xuanvuong1702/flytex-camera/hardware/audit/README.md

# Log kiểm tra ba vòng 8–10

Ba vòng chạy lại toàn bộ trên commit `8a23349`, không dựa vào kết quả vòng trước.

| Vòng | `run_tests.py` | Test | `readiness.py --full` | Blocker |
|---|---|---|---|---|
| 8 | 47/47 bước | 512 | 26/26 đạt | 0 cứng, 4 cảnh báo |
| 9 | 47/47 bước | 512 | 26/26 đạt | 0 cứng, 4 cảnh báo |
| 10 | 47/47 bước | 512 | 26/26 đạt | 0 cứng, 4 cảnh báo |

- CI GitHub Actions: `success`, run `42642975243`, commit `8a23349`.
- Đây là bằng chứng nội bộ + CI; các phép đo phần cứng thật vẫn thuộc G0 (M-02, M-05, M-36, ILIM, port target, TLS MQTT).

Kết luận: đủ điều kiện **bắt đầu dựng prototype** (schematic/layout) với 1 giả định PACK; không đủ điều kiện sản xuất/giao vận.
