xuanvuong1702/flytex-camera/hardware/kicad/pinout-power.md

# Bảng chân IC nguồn (sinh tự động)

## BQ25070

- Datasheet: https://www.ti.com/lit/ds/symlink/bq25070.pdf
- Footprint: `Package_SON:TI_DQC0010A`

| Pin | Tên | Kiểu |
|---|---|---|
| 1 | IN | power_in |
| 2 | IMON | output |
| 3 | GND | power_in |
| 4 | LDO | power_out |
| 5 | TS | input |
| 6 | BAT | passive |
| 7 | CTRL | input |
| 8 | CHG | open_collector |
| 9 | GND | power_in |
| 10 | OUT | power_out |
| 11 | PAD | power_in |

## TPS61088

- Datasheet: https://www.ti.com/lit/ds/symlink/tps61088.pdf
- Footprint: `Package_DFN_QFN:Texas_VQFN-RHL-20`

| Pin | Tên | Kiểu |
|---|---|---|
| 1 | VCC | power_out |
| 2 | EN | input |
| 3 | FSW | input |
| 4 | SW | passive |
| 5 | SW | passive |
| 6 | SW | passive |
| 7 | SW | passive |
| 8 | BOOT | passive |
| 9 | VIN | power_in |
| 10 | SS | passive |
| 11 | NC | no_connect |
| 12 | NC | no_connect |
| 13 | MODE | input |
| 14 | VOUT | power_out |
| 15 | VOUT | passive |
| 16 | VOUT | passive |
| 17 | FB | input |
| 18 | COMP | passive |
| 19 | ILIM | passive |
| 20 | AGND | power_in |
| 21 | PGND | power_in |

## TPS62840

- Datasheet: https://www.ti.com/lit/ds/symlink/tps62840.pdf
- Footprint: `Package_SON:VSON-8_1.5x2mm_P0.5mm`

| Pin | Tên | Kiểu |
|---|---|---|
| 1 | GND | power_in |
| 2 | VIN | power_in |
| 3 | MODE | input |
| 4 | EN | input |
| 5 | VSET | input |
| 6 | STOP | input |
| 7 | SW | passive |
| 8 | VOS | input |
| 9 | PAD | power_in |

## TPS22918

- Datasheet: https://www.ti.com/lit/ds/symlink/tps22918.pdf
- Footprint: `Package_TO_SOT_SMD:SOT-23-6`

| Pin | Tên | Kiểu |
|---|---|---|
| 1 | VIN | power_in |
| 2 | GND | power_in |
| 3 | ON | input |
| 4 | CT | passive |
| 5 | QOD | passive |
| 6 | VOUT | power_out |
