xuanvuong1702/flytex-camera/docs/18-tai-lieu-linh-kien.md

# 18 — Tài liệu linh kiện và đối chiếu thiết kế

- Trạng thái: rà soát v1.0, ngày 2026-11-09
- Nguồn máy đọc: [spec/parts.toml](../spec/parts.toml) → sinh [hardware/parts-register.md](../hardware/parts-register.md)
- Công cụ: `python -m hardware.parts.check --strict` (cổng trước khi mua)

## 1. Cách làm

1. Mỗi linh kiện trong BOM có một mục trong `spec/parts.toml`: MPN, nhà sản xuất, URL datasheet, gói, các thông số then chốt, mức xác minh.
2. Mức xác minh: `yes` = đã mở datasheet và đối chiếu; `partial` = mới một phần; `no` = chưa mở, không được dùng để chốt mua.
3. Bộ kiểm tra đối chiếu từng thông số với yêu cầu thiết kế (dải áp, dòng, nhiệt, gói, chức năng) và bắt buộc mọi MPN quan trọng trong BOM phải có trong sổ.
4. Còn `blocker` thì **không đặt hàng**; `warn` thì ghi nhận và đo/kiểm ở G0.

## 2. Kết quả hiện tại

**15 linh kiện + 4 module ngoài BOM; 0 blocker cứng, 1 giả định PACK, 4 cảnh báo** (sau khi chọn BQ25070 và nhập pinout).

### 2.1 Giả định phải đo trước G0

| Mục | Vấn đề | Cách đóng | Nơi ghi |
|---|---|---|---|
| U3 sạc | **BQ25070**: float 3,5 V, power-path (1,2 A), NTC, standalone; **935 mA bằng 11 xung CTRL**; R1/R2 = 20 kΩ/8,25 kΩ | Còn đo M-05, kiểm tồn kho và đo đỉnh tải | O-05 |
| SOC | Đã nạp **112 chân** Core1106D vào `spec/core1106d/pins.csv` | Đối chiếu với bản vẽ cơ khí và bảng ánh xạ CMP trước khi vẽ | O-11 |
| PACK | Giả định BMS tự tiêu **50 µA**; UN38.3/IEC đang chờ | Chỉ prototype trên bàn; đo M-02; `--production` sẽ fail tới khi có hồ sơ | O-03 |

### 2.2 Cảnh báo (không chặn đặt, phải đo ở G0)

| Mục | Vấn đề | Xử lý |
|---|---|---|
| MODEM | Đỉnh dòng 2 A là giả định | Đo M-36 bằng shunt + oscilloscope; nếu lớn hơn, tách rail modem hoặc boost lớn hơn |
| J1 USB-C | Receptacle hiện chưa phải loại chống nước | Chốt O-06 (receptacle IP67 hoặc khoang kín có nắp) trước khi làm vỏ |
| L1 cuộn cảm | Isat 9 A chưa xác minh ở 125 °C | Đọc datasheet Vishay, kiểm đường cong Isat theo nhiệt độ |

## 3. Những gì đã đối chiếu và đúng

| Linh kiện | Đã xác nhận | Ghi chú |
|---|---|---|
| TPS61088 | Gói VQFN-20; Vin 2,7–12 V; Vref 1,204 V; Vout tới 12,6 V | Phù hợp boost 5 V/3 A; ILIM/fsw vẫn cần đối chiếu công thức datasheet |
| TPS62840 | Vin 1,8–6,5 V; Iout 0,75 A; Iq 60 nA; **DLC = SON-8 1,5×2**; VSET=267 kΩ cho 3,3 V | Bản CAM4G đúng; đã đọc Table 1 datasheet |
| STM32L031G6U6 | **UFQFPN-28**; STOP 0,4 µA; 24 GPIO; −40…85 °C | Đủ chân; thiết kế không phụ thuộc I2C wakeup vì MCU thức khi SoC bật |
| M24C32-FMN6TP | **SO-8 150 mil**; 1,7–5,5 V; I2C | Bản CAM4G đúng; lần sửa sang TSSOP-8 là sai, đã khôi phục |
| TPS22918 | 5,5 V; 2 A; Rds(on) ~55 mΩ | Đủ cho +5V_MODEM 1,8 A và +5V_SOC 1,5 A |
| TS3USB221A | USB 2.0 HS; 2 kênh | Dùng cho mux modem/pad nạp (nếu chốt D-20) |
| Core1106D1408 | 1 cổng USB; eMMC 8 GB; 112 chân | Khớp D-19/D-20; thiếu bản vẽ chân |
| EC200U-EU | VBAT 3,3–4,3 V; USB HS; **MAIN_RI chân 62** | Đã có hardware design; còn đo đỉnh dòng/eDRX |

## 4. Tối ưu và điều chỉnh đề xuất

1. **Buck:** nếu TPS62840 chỉ có bản chỉnh được, thêm cặp điện trở hồi tiếp E96 và ghi giá trị vào [pwr-design](../hardware/pwr-design.md) bằng cách mở rộng `hardware/calc/design.py`. Nếu có bản cố định 3,3 V, chọn bản đó để bớt 2 linh kiện và một nguồn sai số.
2. **Sạc:** BQ25798 **không dùng được** cho kiến trúc này (mặc định 4,2 V, watchdog, không có I2C master khi SoC tắt). Chọn IC float LFP bằng phần cứng; nếu là sạc tuyến tính 1 A thì chấp nhận chậm hơn để đổi lấy an toàn.
3. **MCU:** không cần I2C wakeup từ STOP nếu MCU chỉ ngủ khi SoC tắt; khi SoC bật, MCU thức và trả lời I2C. Ghi rõ trong port STM32L0 để người viết không đi tìm tính năng không cần.
4. **B2B:** dòng mỗi chân 1 A của Samtec TSM cần xác nhận trong datasheet; nếu thấp hơn, tăng số chân nguồn hoặc đổi connector.
5. **USB-C:** chốt phương án chống nước trước khi vẽ vỏ, vì nó quyết định khoét vỏ và chiều cao connector.
6. **Đo trước khi tối ưu:** đỉnh modem và dòng ngủ là hai số quyết định kích thước boost/pin; đừng đổi linh kiện trước M-36/M-02.

## 5. Bộ tài liệu cần thu thập (đang thiếu)

| Tài liệu | Cho | Trạng thái |
|---|---|---|
| `Core1106D-PinOut.xls`, `Core1106D.pdf` (Luckfox) | Vẽ CMP, gán chân 112 | **Chưa nạp** |
| EC200U Hardware Design (Quectel) | VBAT, đỉnh dòng, RI, USB | Đã dẫn, chưa trích số |
| Datasheet IC sạc mới (LTC4162-L / LTC4098-3.6 / CN3058E) | Chốt float, NTC, power-path | **Chưa có** |
| TPS62840 datasheet bản gói DLC | Vref, divider, footprint | Chưa đối chiếu |
| TPS61088 datasheet (ILIM, fsw, COMP) | Chốt giá trị bù | Chưa đối chiếu đầy đủ |
| STM32L031 datasheet + reference manual | STOP, I2C, ADC, chân | Một phần |
| SC3336 3MP Camera (B) pinout 20 chân | CMP, firmware camera | **Đã có** trong `spec/camera/` |
| Pack/BMS datasheet, UN38.3, IEC 62133, tự tiêu | Mua pack, an toàn | **Chưa có** |
| Antenna datasheet (VSWR, gain, keepout) | Vỏ, RF | **Chưa có** |
| USB-C receptacle IP67 datasheet | Vỏ | **Chưa có** |
| Bản vẽ cơ khí connector (Samtec, Hirose, Amass) | Footprint, 3D | Một phần |

Danh sách việc và thứ tự ưu tiên trước khi mua: [19-truoc-khi-mua.md](19-truoc-khi-mua.md).

## 6. Cách cập nhật

1. Mở datasheet, xác nhận một thông số.
2. Sửa `spec/parts.toml`: `verified`, `source`, giá trị.
3. `python -m hardware.parts.check --write` để sinh lại bảng.
4. `python -m hardware.parts.check --strict` phải hết blocker mới đặt hàng.
5. Ghi ngày và người xác nhận vào cột `source` hoặc `notes`.

## 7. Đính chính sau rà soát độc lập 2026-11-09

Rà soát bên ngoài (Ubuntu + gcc 13.3 + datasheet) phát hiện các lỗi mà bộ kiểm tra nội bộ không bắt được:

1. **CI đỏ** vì `regmap.c` thiếu `<stddef.h>`; đã sửa 4 file nguồn + 3 header + 9 file test và thêm lint. Run `42613060903` (commit `08a35e7`) đã **success**.
2. **BQ25798 không an toàn** cho LFP 1S; đã loại và thay bằng **BQ25070** (D-23).
3. **Hai đính chính gói ở vòng 1 là sai**: TPS62840 là SON-8 1,5×2, M24C32 là SO-8; đã khôi phục.
4. **NTC 7,15 kΩ** thuộc IC cũ; mục 4 của pwr-design đã tạm hoãn.
5. **+3V3 là 3,0–3,3 V**, không phải 3,3 V cố định.
6. **BOM thiếu linh kiện phụ**; đã thêm các dòng boost/USB/load-switch và đánh dấu phần phụ thuộc IC sạc là `not-chosen`.
7. **Ngưỡng pin LFP** đã sửa (3,05/2,90/3,20 V + lọc/đếm mẫu). **SMS** đã có HMAC/timestamp/chống replay; còn thiếu giới hạn tần suất ở MCU và whitelist số — ghi ở [17](17-san-sang-prototype.md) vòng 7.
8. **Công tắc tải modem TPS22918 (2 A) dùng cho rail 1,8 A** chỉ dư ~11 %; tụ 470 µF sau công tắc có thể tạo dòng nạp vượt 2 A. Đã thêm tụ CT (C9) nhưng phải đo dòng khởi động ở M-36; nếu vượt, đổi công tắc tải lớn hơn hoặc giảm tụ/soft-start.
9. **Tụ ra boost 2×22 µF 1206 10 V X7R** mất nhiều dung lượng do DC bias ở 5 V. Phải tra đường cong C(V) trong datasheet tụ, có thể phải tăng số tụ hoặc dùng 16 V; kiểm gợn và ổn định ở M-08.

Bài học: test BOM chỉ kiểm **nhất quán nội bộ**, không chứng minh gói hay thông số đúng datasheet. Mọi `verified=yes` phải kèm nguồn và người kiểm.
