xuanvuong1702/flytex-camera/spec/generated/pinout_pwr_cmp.csv

pin | signal | net | direction | max_a
1 | +5V_SOC | +5V_SOC | PWR->CMP | 1.0
2 | +5V_MODEM | +5V_MODEM | PWR->CMP | 1.0
3 | +5V_SOC | +5V_SOC | PWR->CMP | 1.0
4 | +5V_MODEM | +5V_MODEM | PWR->CMP | 1.0
5 | +5V_SOC | +5V_SOC | PWR->CMP | 1.0
6 | GND | GND | - | 1.0
7 | GND | GND | - | 1.0
8 | GND | GND | - | 1.0
9 | +3V3 | +3V3 | PWR->CMP | 0.75
10 | GND | GND | - | 1.0
11 | +3V3 | +3V3 | PWR->CMP | 0.75
12 | GND | GND | - | 1.0
13 | I2C_SDA | I2C_SDA | bidir
14 | I2C_SCL | I2C_SCL | bidir
15 | MCU_IRQ | MCU_IRQ | PWR->CMP
16 | SOC_READY | SOC_READY | CMP->PWR
17 | MODEM_PWRKEY | MODEM_PWRKEY | PWR->CMP
18 | MODEM_RESET | MODEM_RESET | PWR->CMP
19 | MODEM_STATUS | MODEM_STATUS | CMP->PWR
20 | USB_SEL | USB_SEL | PWR->CMP
21 | MODEM_RI | MODEM_RI | CMP->PWR
22 | SPARE_SOC2 | SPARE_SOC2 | CMP->PWR
23 | +5V_MODEM | +5V_MODEM | PWR->CMP | 1.0
24 | GND | GND | - | 1.0
25 | GND | GND | - | 1.0
26 | GND | GND | - | 1.0
