xuanvuong1702/flytex-camera/hardware/kicad/flytex-cmp-full.png

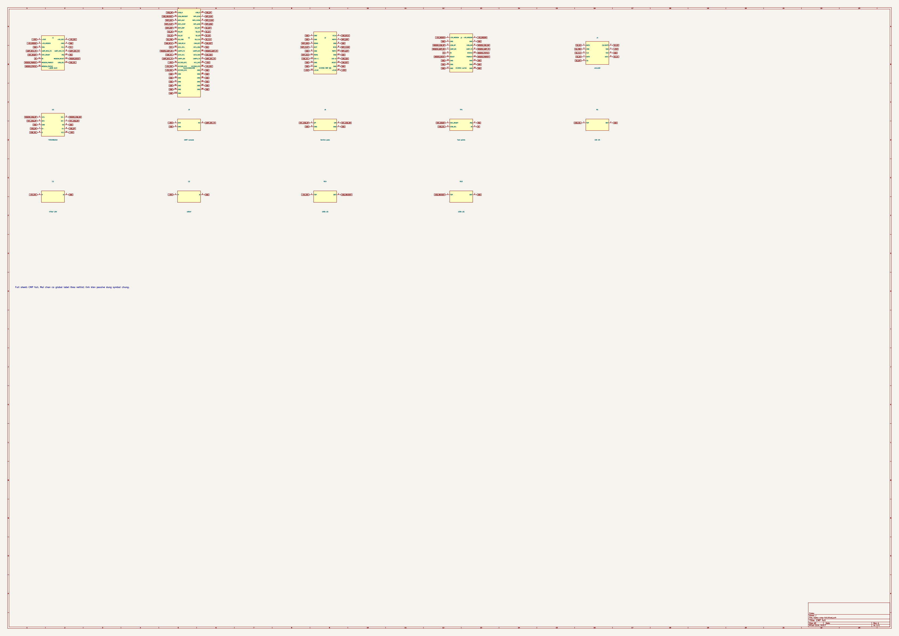
hardware/kicad/flytex-cmp-full.png
