xuanvuong1702/flytex-camera/hardware/kicad/flytex-pwr-full.png

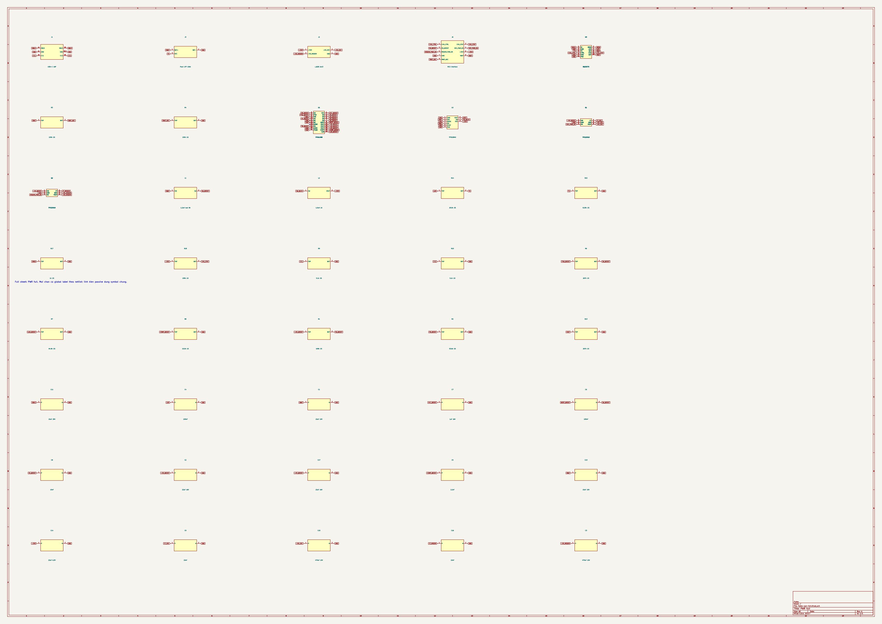
hardware/kicad/flytex-pwr-full.png
