xuanvuong1702/flytex-camera/hardware/kicad/flytex-pwr.png

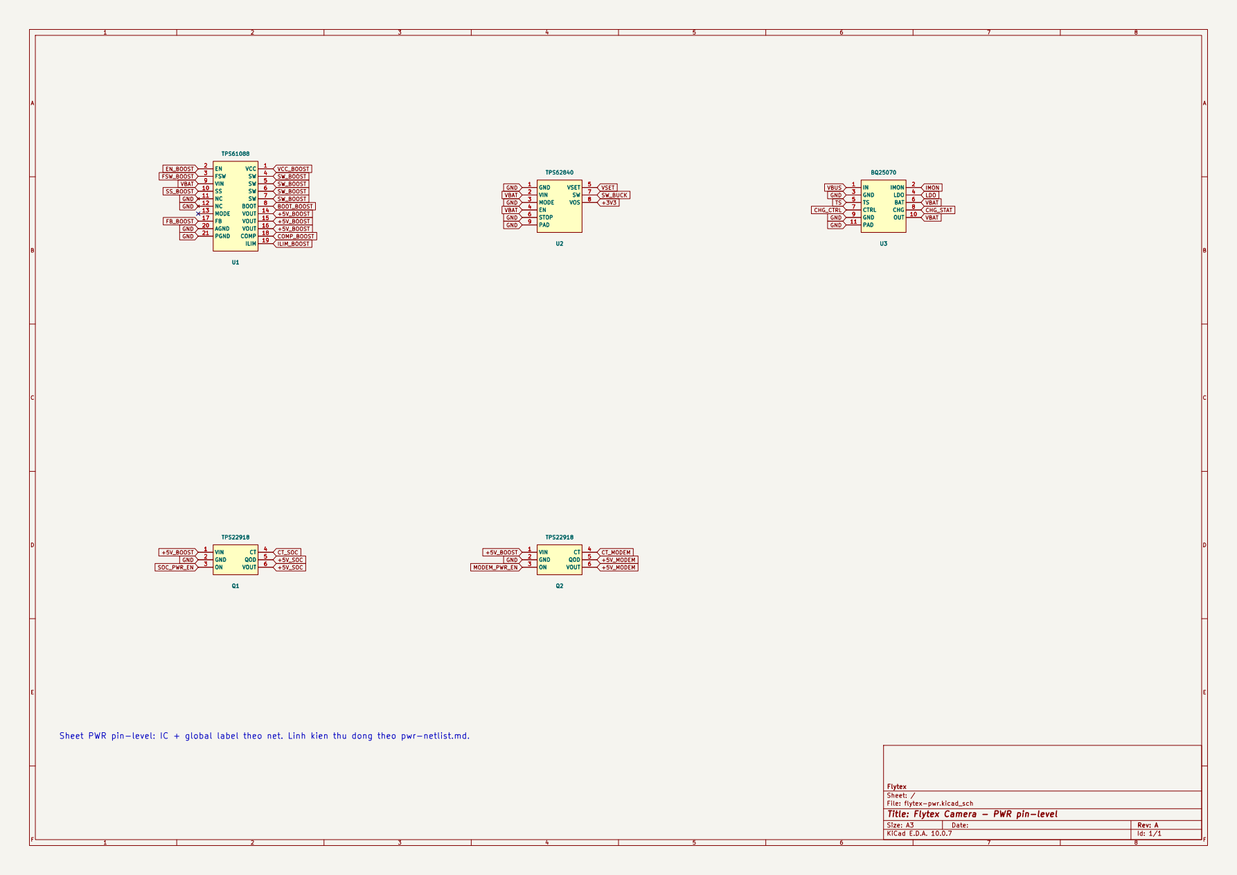
hardware/kicad/flytex-pwr.png
