xuanvuong1702/flytex-camera/devkit/bom.csv

item | qty | example | role | approx_usd | note
SBC | 1 | Luckfox Pico Ultra (RV1106 | 256MB | WiFi) | Chạy Linux + camera + app | 45 | Cần board có FPC camera và USB host; nếu có Core1106D dev board thì dùng board đó
Camera | 1 | Luckfox SC3336 3MP module B | Camera MIPI 2 lane | 25 | Đúng module B; kiểm FPC 20 pin 0.5 mm
Modem | 1 | Quectel EC200U-EU EVB (USB) | 4G Cat.1 + USB + SIM | 55 | EVB có USB; kiểm ăng-ten và SIM
Antenna | 1 | LTE antenna SMA + u.FL adapter | Thu phát LTE | 8 | Đúng băng tần 700/800/900/1800/2100 MHz
SIM | 1 | SIM data LTE (Viettel/Vina/Mobi) | Kết nối mạng | 5 | Có APN; gói data tối thiểu
PSU | 1 | 5V 3A DC adapter + đầu DC/dupont | Cấp nguồn qua header 5V/GND | 12 | Không cấp qua USB-C nếu cắm modem USB-A; kiểm silkscreen 5V
USB-TTL | 1 | CH340/CP2102 3.3V | UART console/debug | 5 | Mức 3.3V, không dùng 5V TTL
Hub | 1 | USB 2.0 hub có nguồn 5V/2A | Cắm modem qua USB-A | 12 | Modem đỉnh >1,5 A; hub phải đủ dòng
microSD | 1 | 16GB Class10 | Image/boot | 8 | Kiểm board boot từ SD hay eMMC
Power meter | 1 | USB-C/DC power meter hoặc shunt | Đo dòng/áp | 15 | Đo nhánh Pico và nhánh modem
Wires | 1 | Bộ dây dupont + SMA pigtail | Đấu nối | 6 | Giữ ngắn, tránh vòng dây nguồn
Enclosure | 1 | Hộp nhựa 100x70x30 mm | Đựng board | 5 | Tùy chọn cho test
Battery | 0 | - | Chỉ khi test nguồn pin | - | Devkit chạy nguồn bench trước; pack để sau
PoE | 1 | Luckfox PoE module (tuỳ chọn) | Cấp nguồn qua Ethernet để giữ USB-A | 15 | Cần switch/PoE injector 802.3af
