xuanvuong1702/flytex-camera/hardware/bom/pwr-rev-a.csv

ref | block | value | mpn | manufacturer | package | qty | dnp | verify | notes
U1 | boost | 5V 3A boost | TPS61088RHLR | Texas Instruments | VQFN-20 | 1 | no | candidate | Vref va fsw va ilim phai doi chieu datasheet
U2 | buck | 3V3 0.75A buck | TPS62840DLCR | Texas Instruments | SON-8 1.5x2mm | 1 | no | candidate | Goi DLC = SON-8 1.5x2 (CAM4G dung); dat VOUT bang dien tro VSET (khong phai divider 2R)
U3 | charger | 1S LFP linear charger 1A | BQ25070DQCR | Texas Instruments | WSON-10 3x2mm | 1 | no | candidate | Float 3.5 V co dinh + power path + NTC + standalone; 1 A tuyen tinh ~1.5 W; phai doc datasheet de tinh CTRL/NTC
U4 | mcu | STM32L031G6U6 | STM32L031G6U6 | STMicroelectronics | UFQFPN-28 | 1 | no | candidate | Goi G6 = UFQFPN-28; kiem chan I2C wakeup va STOP
U5 | nvm | 32Kbit I2C EEPROM | M24C32-FMN6TP | STMicroelectronics | SO-8 150mil | 1 | no | candidate | Luu mode/lich/boot count; MN = SO8
Q1 | soc_switch | load switch TPS22918 | TPS22918DBVR | Texas Instruments | SOT-23-6 | 1 | no | candidate | Rail +5V_SOC
Q2 | modem_switch | load switch TPS22918 | TPS22918DBVR | Texas Instruments | SOT-23-6 | 1 | no | candidate | Rail +5V_MODEM >=1.8 A
L1 | boost | 1.2uH Isat 9A | IHLP2525CZER1R2M01 | Vishay | 2525 | 1 | no | candidate | Kiem Isat o 125 do C
D1 | usb_esd | ESD array USBLC6-2SC6 | USBLC6-2SC6 | STMicroelectronics | SOT-23-6 | 1 | no | candidate | USB-C VBUS va D-/D+ khong dung
F1 | usb_ptc | PTC 0.75A 30V | MF-MSMF075 | BOURNS | 1812 | 1 | no | candidate | Bao ve cong USB-C
J1 | usb_c | USB-C receptacle 16P | USB4085-GF-A | GCT | USB-C | 1 | no | candidate | Phien ban chong nuoc la O-06
J2 | b2b | header 2x13 2.54 keyed | TSM-113-01-L-DV | Samtec | 2x13 | 1 | no | candidate | Phai khop spec/b2b.toml 26 chan
J3 | pack | BAT+ BAT- >=10A | XT30PW-M | Amass | 2 pin | 1 | no | candidate | Co khoa chong nguoc
J4 | swd | header 1x6 2.54 | TSW-106-07-G-S | Samtec | 1x6 | 1 | no | candidate | SWDIO SWCLK NRST GND 3V3
J5 | sensors | header 1x6 2.54 | TSW-106-07-G-S | Samtec | 1x6 | 1 | no | candidate | 3V3 PIR GND 3V3 DQ GND
R1 | boost_fb | 169k 1% | RC0603FR-07169KL | Yageo | 0603 | 1 | no | candidate | Cap hoi tiep tren
R2 | boost_fb | 53.6k 1% | RC0603FR-0753K6L | Yageo | 0603 | 1 | no | candidate | Cap hoi tiep duoi
R3 | batt_div | 100k 1% | RC0603FR-07100KL | Yageo | 0603 | 1 | no | candidate | Chia ap pin
R4 | batt_div | 100k 1% | RC0603FR-07100KL | Yageo | 0603 | 1 | no | candidate | Chia ap pin
C1 | boost_in | 10uF 25V X7R | CL31B106KBHNNNE | Samsung | 1206 | 2 | no | candidate | Sat IC boost
C2 | boost_out | 22uF 10V X7R | CL31B226KPHNNNE | Samsung | 1206 | 2 | no | candidate
C3 | modem_bulk | 470uF 10V low ESR | EEU-FR1A471 | Panasonic | radial 8x11 | 1 | no | candidate | Dat SAU cong tac tai va sat modem; kiem dong nap voi CT C9
C4 | decouple | 100nF 50V X7R | CL10B104KB8NNNC | Samsung | 0603 | 12 | no | candidate | Theo tung IC
R5 | ntc_pull | 7.15k 1% | RC0603FR-077K15L | Yageo | 0603 | 1 | yes | dnp | KHONG DUNG: gia tri cua IC CAM4G cu
TP1 | testpoint | test point 1.0mm | TP-107-01-T | Samtec | 1 pin | 12 | no | candidate | Moi rail mot diem
R6 | boost_fsw | 267k 1% | RC0603FR-07267KL | Yageo | 0603 | 1 | no | candidate | Rfsw theo datasheet TPS61088
R7 | boost_ilim | 64.9k 1% | RC0603FR-0764K9L | Yageo | 0603 | 1 | no | candidate | Rilim theo datasheet
R8 | boost_comp | 10.5k 1% | RC0603FR-0710K5L | Yageo | 0603 | 1 | no | candidate | Mang COMP - chua do Bode
C5 | boost_comp | 2.2nF 50V X7R | CL10B222KB8NNNC | Samsung | 0603 | 1 | no | candidate | Mang COMP
C6 | boost_boot | 100nF 50V X7R | CL10B104KB8NNNC | Samsung | 0603 | 1 | no | candidate | Tu boot
C7 | boost_vcc | 1uF 16V X7R | CL10B105KO8NNNC | Samsung | 0603 | 1 | no | candidate | Tu VCC
C8 | boost_ss | 10nF 50V X7R | CL10B103KB8NNNC | Samsung | 0603 | 1 | no | candidate | Tu soft-start
R9 | usb_cc | 5.1k 1% | RC0603FR-075K1L | Yageo | 0603 | 1 | no | candidate | Rd cho CC1
R10 | usb_cc | 5.1k 1% | RC0603FR-075K1L | Yageo | 0603 | 1 | no | candidate | Rd cho CC2
D2 | usb_vbus_tvs | TVS 5V standoff | SMBJ5.0A | Bourns | SMB | 1 | no | candidate | Bao ve VBUS; USBLC6 chi bao ve data
C9 | load_switch_ct | 10nF 50V X7R | CL10B103KB8NNNC | Samsung | 0603 | 2 | no | candidate | Chinh slew dong nap 470uF
L2 | buck_inductor | 1.0uH 1.2A | LQH3NPN1R0MM0L | Murata | 1210 | 1 | no | candidate | Cuon cam buck 3V3; kiem Isat/DCR
C10 | charger_pmid | chua chon |  |  | chua chon | 1 | yes | dnp | Khong dung cho sac tuyen tinh
C11 | charger_vbus | 10uF 16V X7R | CL31B106KO8NNNE | Samsung | 1206 | 1 | no | candidate | Tu vao VBUS theo datasheet BQ25070
C12 | charger_sys | 10uF 10V X7R | CL31B106KPHNNNE | Samsung | 1206 | 2 | no | candidate | Tu SYS/BAT theo datasheet BQ25070
R11 | charger_ctrl | KHONG DUNG (CTRL xung) |  |  | chua chon | 1 | yes | dnp | BQ25070 CTRL la giao dien xung 1 day - khong co dien tro; can GPIO MCU
R14 | charger_ts_top | 20.0k 1% | RC0603FR-0720KL | Yageo | 0603 | 1 | no | candidate | R1 LDO->TS theo datasheet BQ25070; cat nong 44.9 C
R15 | charger_ts_bottom | 8.25k 1% | RC0603FR-078K25L | Yageo | 0603 | 1 | no | candidate | R2 TS->GND; cat lanh -0.6 C
R13 | buck_vset | 267k 1% | RC0603FR-07267KL | Yageo | 0603 | 1 | no | candidate | VSET=267k theo Table 1 datasheet TPS62840 (trang 13) cho VOUT 3.3 V
R16 | buck_mode | 0R 1% | RC0603FR-070RL | Yageo | 0603 | 1 | no | candidate | Keo MODE xuong GND: PFM cho dong nghi thap
R17 | charger_imon | 1k 1% | RC0603FR-071KL | Yageo | 0603 | 1 | no | candidate | IMON: 1 V tuong ung 1 A
R18 | charger_chg | 100k 1% | RC0603FR-07100KL | Yageo | 0603 | 1 | no | candidate | Pull-up CHG (open-drain) len +3V3
C13 | buck_in | 10uF 10V X7R | CL31B106KPHNNNE | Samsung | 1206 | 1 | no | candidate | Tu vao buck 3V3
C14 | buck_out | 22uF 6.3V X7R | CL31B226KPHNNNE | Samsung | 1206 | 1 | no | candidate | Tu ra buck 3V3
C15 | soc_bulk | 470uF 10V low ESR | EEU-FR1A471 | Panasonic | radial 8x11 | 1 | no | candidate | Bulk rail +5V_SOC
C16 | load_switch_ct | 10nF 50V X7R | CL10B103KB8NNNC | Samsung | 0603 | 1 | no | candidate | CT cho cong tac modem
C17 | boost_out | 22uF 16V X7R | CL31B226KOHNNNE | Samsung | 1206 | 1 | no | candidate | Tu ra boost thu hai
J6 | mcu_if | header 1x9 2.54 | TSW-109-07-G-S | Samtec | 1x9 | 1 | no | candidate | CHG_CTRL CHG_STAT EN_BOOST SOC/MODEM_PWR_EN 3V3 GND VBAT VBAT_ADC
