xuanvuong1702/flytex-camera/hardware/netlist/cmp-netlist.csv

ref | value | footprint | pin | pin_name | net
J1 | J_B2B 2x13 | Connector_PinSocket_2.54mm:PinSocket_2x13_P2.54mm_Vertical | 1 | +3V3 | +3V3
J1 | J_B2B 2x13 | Connector_PinSocket_2.54mm:PinSocket_2x13_P2.54mm_Vertical | 2 | +5V_SOC | +5V_SOC
J1 | J_B2B 2x13 | Connector_PinSocket_2.54mm:PinSocket_2x13_P2.54mm_Vertical | 3 | +5V_MODEM | +5V_MODEM
J1 | J_B2B 2x13 | Connector_PinSocket_2.54mm:PinSocket_2x13_P2.54mm_Vertical | 4 | GND | GND
J1 | J_B2B 2x13 | Connector_PinSocket_2.54mm:PinSocket_2x13_P2.54mm_Vertical | 5 | SDA | SDA
J1 | J_B2B 2x13 | Connector_PinSocket_2.54mm:PinSocket_2x13_P2.54mm_Vertical | 6 | SCL | SCL
J1 | J_B2B 2x13 | Connector_PinSocket_2.54mm:PinSocket_2x13_P2.54mm_Vertical | 7 | UART_MCU_TX | UART_MCU_TX
J1 | J_B2B 2x13 | Connector_PinSocket_2.54mm:PinSocket_2x13_P2.54mm_Vertical | 8 | UART_SOC_TX | UART_SOC_TX
J1 | J_B2B 2x13 | Connector_PinSocket_2.54mm:PinSocket_2x13_P2.54mm_Vertical | 9 | SOC_READY | SOC_READY
J1 | J_B2B 2x13 | Connector_PinSocket_2.54mm:PinSocket_2x13_P2.54mm_Vertical | 10 | IRQ | IRQ
J1 | J_B2B 2x13 | Connector_PinSocket_2.54mm:PinSocket_2x13_P2.54mm_Vertical | 11 | RI | RI
J1 | J_B2B 2x13 | Connector_PinSocket_2.54mm:PinSocket_2x13_P2.54mm_Vertical | 12 | MODEM_RESET | MODEM_RESET
J1 | J_B2B 2x13 | Connector_PinSocket_2.54mm:PinSocket_2x13_P2.54mm_Vertical | 13 | MODEM_PWRKEY | MODEM_PWRKEY
J1 | J_B2B 2x13 | Connector_PinSocket_2.54mm:PinSocket_2x13_P2.54mm_Vertical | 14 | USB_SEL | USB_SEL
J1 | J_B2B 2x13 | Connector_PinSocket_2.54mm:PinSocket_2x13_P2.54mm_Vertical | 15 | MODEM_STATUS | MODEM_STATUS
U1 | Core1106D1408 | flytex:Core1106D | 22 | USB_N | USB_DM
U1 | Core1106D1408 | flytex:Core1106D | 23 | USB_P | USB_DP
U1 | Core1106D1408 | flytex:Core1106D | 24 | USB_VBUSDET | USB_VBUSDET
U1 | Core1106D1408 | flytex:Core1106D | 7 | MIPI_D1N | MIPI_D1N
U1 | Core1106D1408 | flytex:Core1106D | 8 | MIPI_D1P | MIPI_D1P
U1 | Core1106D1408 | flytex:Core1106D | 9 | MIPI_CK0N | MIPI_CLKN
U1 | Core1106D1408 | flytex:Core1106D | 10 | MIPI_CK0P | MIPI_CLKP
U1 | Core1106D1408 | flytex:Core1106D | 11 | MIPI_D0N | MIPI_D0N
U1 | Core1106D1408 | flytex:Core1106D | 12 | MIPI_D0P | MIPI_D0P
U1 | Core1106D1408 | flytex:Core1106D | 48 | SD_DET | SD_DET
U1 | Core1106D1408 | flytex:Core1106D | 49 | SD_D0 | SD_D0
U1 | Core1106D1408 | flytex:Core1106D | 50 | SD_D1 | SD_D1
U1 | Core1106D1408 | flytex:Core1106D | 51 | SD_D2 | SD_D2
U1 | Core1106D1408 | flytex:Core1106D | 52 | SD_D3 | SD_D3
U1 | Core1106D1408 | flytex:Core1106D | 53 | SD_CMD | SD_CMD
U1 | Core1106D1408 | flytex:Core1106D | 54 | SD_CLK | SD_CLK
U1 | Core1106D1408 | flytex:Core1106D | 58 | CAM_MCLK | CAM_MCLK
U1 | Core1106D1408 | flytex:Core1106D | 60 | CAM_RST | CAM_RST
U1 | Core1106D1408 | flytex:Core1106D | 63 | I2C1_SCL | SCL
U1 | Core1106D1408 | flytex:Core1106D | 64 | I2C1_SDA | SDA
U1 | Core1106D1408 | flytex:Core1106D | 65 | UART3_TX | MODEM_UART_RX
U1 | Core1106D1408 | flytex:Core1106D | 66 | UART3_RX | MODEM_UART_TX
U1 | Core1106D1408 | flytex:Core1106D | 68 | I2C0_SCL | CAM_SCL
U1 | Core1106D1408 | flytex:Core1106D | 69 | I2C0_SDA | CAM_SDA
U1 | Core1106D1408 | flytex:Core1106D | 70 | UART4_RX | UART_MCU_TX
U1 | Core1106D1408 | flytex:Core1106D | 71 | UART4_TX | UART_SOC_TX
U1 | Core1106D1408 | flytex:Core1106D | 76 | VCC3V3_RTC | +3V3
U1 | Core1106D1408 | flytex:Core1106D | 78 | VCC_3V3 | +3V3
U1 | Core1106D1408 | flytex:Core1106D | 79 | VCC5V0_SYS | +5V_SOC
U1 | Core1106D1408 | flytex:Core1106D | 80 | VCC5V0_SYS | +5V_SOC
U1 | Core1106D1408 | flytex:Core1106D | 81 | VCC5V0_SYS | +5V_SOC
U1 | Core1106D1408 | flytex:Core1106D | 21 | GND | GND
U1 | Core1106D1408 | flytex:Core1106D | 25 | GND | GND
U1 | Core1106D1408 | flytex:Core1106D | 28 | GND | GND
U1 | Core1106D1408 | flytex:Core1106D | 29 | GND | GND
U1 | Core1106D1408 | flytex:Core1106D | 36 | GND | GND
U1 | Core1106D1408 | flytex:Core1106D | 47 | GND | GND
U1 | Core1106D1408 | flytex:Core1106D | 55 | GND | GND
U1 | Core1106D1408 | flytex:Core1106D | 82 | GND | GND
U1 | Core1106D1408 | flytex:Core1106D | 83 | GND | GND
U1 | Core1106D1408 | flytex:Core1106D | 84 | GND | GND
U1 | Core1106D1408 | flytex:Core1106D | 89 | GND | GND
U1 | Core1106D1408 | flytex:Core1106D | 112 | GND | GND
J2 | SC3336 3MP (B) | Connector_FFC-FPC:Hirose_FH12-20S-0.5SH_1x20-1MP_P0.50mm_Horizontal | 1 | GND | GND
J2 | SC3336 3MP (B) | Connector_FFC-FPC:Hirose_FH12-20S-0.5SH_1x20-1MP_P0.50mm_Horizontal | 2 | XCLK | CAM_MCLK
J2 | SC3336 3MP (B) | Connector_FFC-FPC:Hirose_FH12-20S-0.5SH_1x20-1MP_P0.50mm_Horizontal | 3 | GND | GND
J2 | SC3336 3MP (B) | Connector_FFC-FPC:Hirose_FH12-20S-0.5SH_1x20-1MP_P0.50mm_Horizontal | 4 | MDP0 | MIPI_D0P
J2 | SC3336 3MP (B) | Connector_FFC-FPC:Hirose_FH12-20S-0.5SH_1x20-1MP_P0.50mm_Horizontal | 5 | MDN0 | MIPI_D0N
J2 | SC3336 3MP (B) | Connector_FFC-FPC:Hirose_FH12-20S-0.5SH_1x20-1MP_P0.50mm_Horizontal | 6 | GND | GND
J2 | SC3336 3MP (B) | Connector_FFC-FPC:Hirose_FH12-20S-0.5SH_1x20-1MP_P0.50mm_Horizontal | 7 | MCP | MIPI_CLKP
J2 | SC3336 3MP (B) | Connector_FFC-FPC:Hirose_FH12-20S-0.5SH_1x20-1MP_P0.50mm_Horizontal | 8 | MCN | MIPI_CLKN
J2 | SC3336 3MP (B) | Connector_FFC-FPC:Hirose_FH12-20S-0.5SH_1x20-1MP_P0.50mm_Horizontal | 9 | GND | GND
J2 | SC3336 3MP (B) | Connector_FFC-FPC:Hirose_FH12-20S-0.5SH_1x20-1MP_P0.50mm_Horizontal | 10 | MDP1 | MIPI_D1P
J2 | SC3336 3MP (B) | Connector_FFC-FPC:Hirose_FH12-20S-0.5SH_1x20-1MP_P0.50mm_Horizontal | 11 | MDN1 | MIPI_D1N
J2 | SC3336 3MP (B) | Connector_FFC-FPC:Hirose_FH12-20S-0.5SH_1x20-1MP_P0.50mm_Horizontal | 12 | GND | GND
J2 | SC3336 3MP (B) | Connector_FFC-FPC:Hirose_FH12-20S-0.5SH_1x20-1MP_P0.50mm_Horizontal | 13 | SIO-C | CAM_SCL
J2 | SC3336 3MP (B) | Connector_FFC-FPC:Hirose_FH12-20S-0.5SH_1x20-1MP_P0.50mm_Horizontal | 14 | SIO-D | CAM_SDA
J2 | SC3336 3MP (B) | Connector_FFC-FPC:Hirose_FH12-20S-0.5SH_1x20-1MP_P0.50mm_Horizontal | 15 | GND | GND
J2 | SC3336 3MP (B) | Connector_FFC-FPC:Hirose_FH12-20S-0.5SH_1x20-1MP_P0.50mm_Horizontal | 16 | RESET | CAM_RST
J2 | SC3336 3MP (B) | Connector_FFC-FPC:Hirose_FH12-20S-0.5SH_1x20-1MP_P0.50mm_Horizontal | 17 | GND | GND
J2 | SC3336 3MP (B) | Connector_FFC-FPC:Hirose_FH12-20S-0.5SH_1x20-1MP_P0.50mm_Horizontal | 18 | GND | GND
J2 | SC3336 3MP (B) | Connector_FFC-FPC:Hirose_FH12-20S-0.5SH_1x20-1MP_P0.50mm_Horizontal | 19 | +3.3V | +3V3
J2 | SC3336 3MP (B) | Connector_FFC-FPC:Hirose_FH12-20S-0.5SH_1x20-1MP_P0.50mm_Horizontal | 20 | +3.3V | +3V3
J3 | EC200U carrier | Connector_PinHeader_2.54mm:PinHeader_2x09_P2.54mm_Vertical | 1 | +5V_MODEM | +5V_MODEM
J3 | EC200U carrier | Connector_PinHeader_2.54mm:PinHeader_2x09_P2.54mm_Vertical | 2 | +5V_MODEM | +5V_MODEM
J3 | EC200U carrier | Connector_PinHeader_2.54mm:PinHeader_2x09_P2.54mm_Vertical | 3 | GND | GND
J3 | EC200U carrier | Connector_PinHeader_2.54mm:PinHeader_2x09_P2.54mm_Vertical | 4 | GND | GND
J3 | EC200U carrier | Connector_PinHeader_2.54mm:PinHeader_2x09_P2.54mm_Vertical | 5 | USB_DP | MODEM_USB_DP
J3 | EC200U carrier | Connector_PinHeader_2.54mm:PinHeader_2x09_P2.54mm_Vertical | 6 | USB_DM | MODEM_USB_DM
J3 | EC200U carrier | Connector_PinHeader_2.54mm:PinHeader_2x09_P2.54mm_Vertical | 7 | UART_RX | MODEM_UART_RX
J3 | EC200U carrier | Connector_PinHeader_2.54mm:PinHeader_2x09_P2.54mm_Vertical | 8 | UART_TX | MODEM_UART_TX
J3 | EC200U carrier | Connector_PinHeader_2.54mm:PinHeader_2x09_P2.54mm_Vertical | 9 | RI | RI
J3 | EC200U carrier | Connector_PinHeader_2.54mm:PinHeader_2x09_P2.54mm_Vertical | 10 | STATUS | MODEM_STATUS
J3 | EC200U carrier | Connector_PinHeader_2.54mm:PinHeader_2x09_P2.54mm_Vertical | 11 | RESET | MODEM_RESET
J3 | EC200U carrier | Connector_PinHeader_2.54mm:PinHeader_2x09_P2.54mm_Vertical | 12 | PWRKEY | MODEM_PWRKEY
J3 | EC200U carrier | Connector_PinHeader_2.54mm:PinHeader_2x09_P2.54mm_Vertical | 13 | GND | GND
J3 | EC200U carrier | Connector_PinHeader_2.54mm:PinHeader_2x09_P2.54mm_Vertical | 14 | GND | GND
J3 | EC200U carrier | Connector_PinHeader_2.54mm:PinHeader_2x09_P2.54mm_Vertical | 15 | GND | GND
J3 | EC200U carrier | Connector_PinHeader_2.54mm:PinHeader_2x09_P2.54mm_Vertical | 16 | GND | GND
J3 | EC200U carrier | Connector_PinHeader_2.54mm:PinHeader_2x09_P2.54mm_Vertical | 17 | GND | GND
J3 | EC200U carrier | Connector_PinHeader_2.54mm:PinHeader_2x09_P2.54mm_Vertical | 18 | GND | GND
J4 | microSD | Connector_Card:microSD_HC_Hirose_DM3AT | 1 | DAT2 | SD_D2
J4 | microSD | Connector_Card:microSD_HC_Hirose_DM3AT | 2 | CD/DAT3 | SD_D3
J4 | microSD | Connector_Card:microSD_HC_Hirose_DM3AT | 3 | CMD | SD_CMD
J4 | microSD | Connector_Card:microSD_HC_Hirose_DM3AT | 4 | VDD | +3V3
J4 | microSD | Connector_Card:microSD_HC_Hirose_DM3AT | 5 | CLK | SD_CLK
J4 | microSD | Connector_Card:microSD_HC_Hirose_DM3AT | 6 | VSS | GND
J4 | microSD | Connector_Card:microSD_HC_Hirose_DM3AT | 7 | DAT0 | SD_D0
J4 | microSD | Connector_Card:microSD_HC_Hirose_DM3AT | 8 | DAT1 | SD_D1
J4 | microSD | Connector_Card:microSD_HC_Hirose_DM3AT | 9 | CD | SD_DET
U2 | TS3USB221A | Package_DFN_QFN:UQFN-10_1.4x1.8mm_P0.4mm | 1 | 1D+ | MODEM_USB_DP
U2 | TS3USB221A | Package_DFN_QFN:UQFN-10_1.4x1.8mm_P0.4mm | 2 | 1D- | MODEM_USB_DM
U2 | TS3USB221A | Package_DFN_QFN:UQFN-10_1.4x1.8mm_P0.4mm | 3 | 2D+ | SVC_USB_DP
U2 | TS3USB221A | Package_DFN_QFN:UQFN-10_1.4x1.8mm_P0.4mm | 4 | 2D- | SVC_USB_DM
U2 | TS3USB221A | Package_DFN_QFN:UQFN-10_1.4x1.8mm_P0.4mm | 5 | GND | GND
U2 | TS3USB221A | Package_DFN_QFN:UQFN-10_1.4x1.8mm_P0.4mm | 6 | OE | GND
U2 | TS3USB221A | Package_DFN_QFN:UQFN-10_1.4x1.8mm_P0.4mm | 7 | D- | USB_DM
U2 | TS3USB221A | Package_DFN_QFN:UQFN-10_1.4x1.8mm_P0.4mm | 8 | D+ | USB_DP
U2 | TS3USB221A | Package_DFN_QFN:UQFN-10_1.4x1.8mm_P0.4mm | 9 | S | USB_SEL
U2 | TS3USB221A | Package_DFN_QFN:UQFN-10_1.4x1.8mm_P0.4mm | 10 | VCC | +3V3
J5 | UART console | Connector_PinHeader_2.54mm:PinHeader_1x03_P2.54mm_Vertical | 1 | 3V3 | +3V3
J5 | UART console | Connector_PinHeader_2.54mm:PinHeader_1x03_P2.54mm_Vertical | 2 | RX | UART_SOC_TX
J5 | UART console | Connector_PinHeader_2.54mm:PinHeader_1x03_P2.54mm_Vertical | 3 | GND | GND
J6 | Service pads | Connector_Generic:Conn_01x04 | 1 | DP | SVC_USB_DP
J6 | Service pads | Connector_Generic:Conn_01x04 | 2 | DM | SVC_USB_DM
J6 | Service pads | Connector_Generic:Conn_01x04 | 3 | GND | GND
J6 | Service pads | Connector_Generic:Conn_01x04 | 4 | GND | GND
TP1 | Test points | Connector_Generic:Conn_01x04 | 1 | SOC_READY | SOC_READY
TP1 | Test points | Connector_Generic:Conn_01x04 | 2 | IRQ | IRQ
TP1 | Test points | Connector_Generic:Conn_01x04 | 3 | USB_SEL | USB_SEL
TP1 | Test points | Connector_Generic:Conn_01x04 | 4 | RI | RI
R1 | 10k 1% | Resistor_SMD:R_0603_1608Metric | 1 | TOP | USB_SEL
R1 | 10k 1% | Resistor_SMD:R_0603_1608Metric | 2 | BOT | GND
C1 | 470uF 10V | Capacitor_SMD:CP_Elec_8x10 | 1 | P | +5V_SOC
C1 | 470uF 10V | Capacitor_SMD:CP_Elec_8x10 | 2 | N | GND
C2 | 100nF | Capacitor_SMD:C_0603_1608Metric | 1 | P | +3V3
C2 | 100nF | Capacitor_SMD:C_0603_1608Metric | 2 | N | GND
R14 | 100k 1% | Resistor_SMD:R_0603_1608Metric | 1 | TOP | +5V_SOC
R14 | 100k 1% | Resistor_SMD:R_0603_1608Metric | 2 | BOT | USB_VBUSDET
R15 | 100k 1% | Resistor_SMD:R_0603_1608Metric | 1 | TOP | USB_VBUSDET
R15 | 100k 1% | Resistor_SMD:R_0603_1608Metric | 2 | BOT | GND
