xuanvuong1702/flytex-camera/hardware/netlist/pwr-netlist.csv

ref | value | footprint | pin | pin_name | net
J1 | USB-C 16P | Connector_USB:USB_C_Receptacle_USB2.0_16P | A4 | VBUS | VBUS
J1 | USB-C 16P | Connector_USB:USB_C_Receptacle_USB2.0_16P | B9 | VBUS | VBUS
J1 | USB-C 16P | Connector_USB:USB_C_Receptacle_USB2.0_16P | A1 | GND | GND
J1 | USB-C 16P | Connector_USB:USB_C_Receptacle_USB2.0_16P | B12 | GND | GND
J1 | USB-C 16P | Connector_USB:USB_C_Receptacle_USB2.0_16P | A5 | CC1 | CC1
J1 | USB-C 16P | Connector_USB:USB_C_Receptacle_USB2.0_16P | B5 | CC2 | CC2
J3 | Pack LFP 15Ah | Connector_AMASS:AMASS_XT30PW-M_1x02_P2.50mm_Horizontal | 1 | BAT+ | VBAT
J3 | Pack LFP 15Ah | Connector_AMASS:AMASS_XT30PW-M_1x02_P2.50mm_Horizontal | 2 | BAT- | GND
J3 | Pack LFP 15Ah | Connector_AMASS:AMASS_XT30PW-M_1x02_P2.50mm_Horizontal | 3 | NTC | TS
J2 | J_B2B 2x13 | Connector_Generic:Conn_02x13_Odd_Even | 1 | +3V3 | +3V3
J2 | J_B2B 2x13 | Connector_Generic:Conn_02x13_Odd_Even | 2 | +5V_SOC | +5V_SOC
J2 | J_B2B 2x13 | Connector_Generic:Conn_02x13_Odd_Even | 3 | +5V_MODEM | +5V_MODEM
J2 | J_B2B 2x13 | Connector_Generic:Conn_02x13_Odd_Even | 4 | GND | GND
J6 | MCU interface | Connector_PinHeader_2.54mm:PinHeader_1x09_P2.54mm_Vertical | 1 | CHG_CTRL | CHG_CTRL
J6 | MCU interface | Connector_PinHeader_2.54mm:PinHeader_1x09_P2.54mm_Vertical | 2 | CHG_STAT | CHG_STAT
J6 | MCU interface | Connector_PinHeader_2.54mm:PinHeader_1x09_P2.54mm_Vertical | 3 | EN_BOOST | EN_BOOST
J6 | MCU interface | Connector_PinHeader_2.54mm:PinHeader_1x09_P2.54mm_Vertical | 4 | SOC_PWR_EN | SOC_PWR_EN
J6 | MCU interface | Connector_PinHeader_2.54mm:PinHeader_1x09_P2.54mm_Vertical | 5 | MODEM_PWR_EN | MODEM_PWR_EN
J6 | MCU interface | Connector_PinHeader_2.54mm:PinHeader_1x09_P2.54mm_Vertical | 6 | +3V3 | +3V3
J6 | MCU interface | Connector_PinHeader_2.54mm:PinHeader_1x09_P2.54mm_Vertical | 7 | GND | GND
J6 | MCU interface | Connector_PinHeader_2.54mm:PinHeader_1x09_P2.54mm_Vertical | 8 | VBAT | VBAT
J6 | MCU interface | Connector_PinHeader_2.54mm:PinHeader_1x09_P2.54mm_Vertical | 9 | VBAT_ADC | VBAT_ADC
U3 | BQ25070 | Package_SON:TI_DQC0010A | 1 | IN | VBUS
U3 | BQ25070 | Package_SON:TI_DQC0010A | 2 | IMON | IMON
U3 | BQ25070 | Package_SON:TI_DQC0010A | 3 | GND | GND
U3 | BQ25070 | Package_SON:TI_DQC0010A | 4 | LDO | LDO
U3 | BQ25070 | Package_SON:TI_DQC0010A | 5 | TS | TS
U3 | BQ25070 | Package_SON:TI_DQC0010A | 6 | BAT | VBAT
U3 | BQ25070 | Package_SON:TI_DQC0010A | 7 | CTRL | CHG_CTRL
U3 | BQ25070 | Package_SON:TI_DQC0010A | 8 | CHG | CHG_STAT
U3 | BQ25070 | Package_SON:TI_DQC0010A | 9 | GND | GND
U3 | BQ25070 | Package_SON:TI_DQC0010A | 10 | OUT | VBAT
U3 | BQ25070 | Package_SON:TI_DQC0010A | 11 | PAD | GND
R3 | 100k 1% | Resistor_SMD:R_0603_1608Metric | 1 | TOP | VBAT
R3 | 100k 1% | Resistor_SMD:R_0603_1608Metric | 2 | BOT | VBAT_ADC
R4 | 100k 1% | Resistor_SMD:R_0603_1608Metric | 1 | TOP | VBAT_ADC
R4 | 100k 1% | Resistor_SMD:R_0603_1608Metric | 2 | BOT | GND
U1 | TPS61088 | Package_DFN_QFN:VQFN-20-1EP_3.5x3.5mm_P0.5mm_EP2.1x2.1mm | 1 | VCC | VCC_BOOST
U1 | TPS61088 | Package_DFN_QFN:VQFN-20-1EP_3.5x3.5mm_P0.5mm_EP2.1x2.1mm | 2 | EN | EN_BOOST
U1 | TPS61088 | Package_DFN_QFN:VQFN-20-1EP_3.5x3.5mm_P0.5mm_EP2.1x2.1mm | 3 | FSW | FSW_BOOST
U1 | TPS61088 | Package_DFN_QFN:VQFN-20-1EP_3.5x3.5mm_P0.5mm_EP2.1x2.1mm | 4 | SW | SW_BOOST
U1 | TPS61088 | Package_DFN_QFN:VQFN-20-1EP_3.5x3.5mm_P0.5mm_EP2.1x2.1mm | 5 | SW | SW_BOOST
U1 | TPS61088 | Package_DFN_QFN:VQFN-20-1EP_3.5x3.5mm_P0.5mm_EP2.1x2.1mm | 6 | SW | SW_BOOST
U1 | TPS61088 | Package_DFN_QFN:VQFN-20-1EP_3.5x3.5mm_P0.5mm_EP2.1x2.1mm | 7 | SW | SW_BOOST
U1 | TPS61088 | Package_DFN_QFN:VQFN-20-1EP_3.5x3.5mm_P0.5mm_EP2.1x2.1mm | 8 | BOOT | BOOT_BOOST
U1 | TPS61088 | Package_DFN_QFN:VQFN-20-1EP_3.5x3.5mm_P0.5mm_EP2.1x2.1mm | 9 | VIN | VBAT
U1 | TPS61088 | Package_DFN_QFN:VQFN-20-1EP_3.5x3.5mm_P0.5mm_EP2.1x2.1mm | 10 | SS | SS_BOOST
U1 | TPS61088 | Package_DFN_QFN:VQFN-20-1EP_3.5x3.5mm_P0.5mm_EP2.1x2.1mm | 11 | NC | GND
U1 | TPS61088 | Package_DFN_QFN:VQFN-20-1EP_3.5x3.5mm_P0.5mm_EP2.1x2.1mm | 12 | NC | GND
U1 | TPS61088 | Package_DFN_QFN:VQFN-20-1EP_3.5x3.5mm_P0.5mm_EP2.1x2.1mm | 13 | MODE
U1 | TPS61088 | Package_DFN_QFN:VQFN-20-1EP_3.5x3.5mm_P0.5mm_EP2.1x2.1mm | 14 | VOUT | +5V_BOOST
U1 | TPS61088 | Package_DFN_QFN:VQFN-20-1EP_3.5x3.5mm_P0.5mm_EP2.1x2.1mm | 15 | VOUT | +5V_BOOST
U1 | TPS61088 | Package_DFN_QFN:VQFN-20-1EP_3.5x3.5mm_P0.5mm_EP2.1x2.1mm | 16 | VOUT | +5V_BOOST
U1 | TPS61088 | Package_DFN_QFN:VQFN-20-1EP_3.5x3.5mm_P0.5mm_EP2.1x2.1mm | 17 | FB | FB_BOOST
U1 | TPS61088 | Package_DFN_QFN:VQFN-20-1EP_3.5x3.5mm_P0.5mm_EP2.1x2.1mm | 18 | COMP | COMP_BOOST
U1 | TPS61088 | Package_DFN_QFN:VQFN-20-1EP_3.5x3.5mm_P0.5mm_EP2.1x2.1mm | 19 | ILIM | ILIM_BOOST
U1 | TPS61088 | Package_DFN_QFN:VQFN-20-1EP_3.5x3.5mm_P0.5mm_EP2.1x2.1mm | 20 | AGND | GND
U1 | TPS61088 | Package_DFN_QFN:VQFN-20-1EP_3.5x3.5mm_P0.5mm_EP2.1x2.1mm | 21 | PGND | GND
U2 | TPS62840 | Package_SON:TI_DLC0008A | 1 | GND | GND
U2 | TPS62840 | Package_SON:TI_DLC0008A | 2 | VIN | VBAT
U2 | TPS62840 | Package_SON:TI_DLC0008A | 3 | MODE | GND
U2 | TPS62840 | Package_SON:TI_DLC0008A | 4 | EN | VBAT
U2 | TPS62840 | Package_SON:TI_DLC0008A | 5 | VSET | VSET
U2 | TPS62840 | Package_SON:TI_DLC0008A | 6 | STOP | GND
U2 | TPS62840 | Package_SON:TI_DLC0008A | 7 | SW | SW_BUCK
U2 | TPS62840 | Package_SON:TI_DLC0008A | 8 | VOS | +3V3
U2 | TPS62840 | Package_SON:TI_DLC0008A | 9 | PAD | GND
Q1 | TPS22918 | Package_TO_SOT_SMD:SOT-23-6 | 1 | VIN | +5V_BOOST
Q1 | TPS22918 | Package_TO_SOT_SMD:SOT-23-6 | 2 | GND | GND
Q1 | TPS22918 | Package_TO_SOT_SMD:SOT-23-6 | 3 | ON | SOC_PWR_EN
Q1 | TPS22918 | Package_TO_SOT_SMD:SOT-23-6 | 4 | CT | CT_SOC
Q1 | TPS22918 | Package_TO_SOT_SMD:SOT-23-6 | 5 | QOD | +5V_SOC
Q1 | TPS22918 | Package_TO_SOT_SMD:SOT-23-6 | 6 | VOUT | +5V_SOC
Q2 | TPS22918 | Package_TO_SOT_SMD:SOT-23-6 | 1 | VIN | +5V_BOOST
Q2 | TPS22918 | Package_TO_SOT_SMD:SOT-23-6 | 2 | GND | GND
Q2 | TPS22918 | Package_TO_SOT_SMD:SOT-23-6 | 3 | ON | MODEM_PWR_EN
Q2 | TPS22918 | Package_TO_SOT_SMD:SOT-23-6 | 4 | CT | CT_MODEM
Q2 | TPS22918 | Package_TO_SOT_SMD:SOT-23-6 | 5 | QOD | +5V_MODEM
Q2 | TPS22918 | Package_TO_SOT_SMD:SOT-23-6 | 6 | VOUT | +5V_MODEM
L1 | 1.2uH Isat 9A | Inductor_SMD:L_Vishay_IHLP-2525 | 1 | VIN | VBAT
L1 | 1.2uH Isat 9A | Inductor_SMD:L_Vishay_IHLP-2525 | 2 | SW | SW_BOOST
L2 | 1.0uH 1A | Inductor_SMD:L_0603_1608Metric | 1 | SW | SW_BUCK
L2 | 1.0uH 1A | Inductor_SMD:L_0603_1608Metric | 2 | VOUT | +3V3
R14 | 20.0k 1% | Resistor_SMD:R_0603_1608Metric | 1 | TOP | LDO
R14 | 20.0k 1% | Resistor_SMD:R_0603_1608Metric | 2 | BOT | TS
R15 | 8.25k 1% | Resistor_SMD:R_0603_1608Metric | 1 | TOP | TS
R15 | 8.25k 1% | Resistor_SMD:R_0603_1608Metric | 2 | BOT | GND
R17 | 1k 1% | Resistor_SMD:R_0603_1608Metric | 1 | TOP | IMON
R17 | 1k 1% | Resistor_SMD:R_0603_1608Metric | 2 | BOT | GND
R18 | 100k 1% | Resistor_SMD:R_0603_1608Metric | 1 | TOP | +3V3
R18 | 100k 1% | Resistor_SMD:R_0603_1608Metric | 2 | BOT | CHG_STAT
R9 | 5.1k 1% | Resistor_SMD:R_0603_1608Metric | 1 | TOP | CC1
R9 | 5.1k 1% | Resistor_SMD:R_0603_1608Metric | 2 | BOT | GND
R10 | 5.1k 1% | Resistor_SMD:R_0603_1608Metric | 1 | TOP | CC2
R10 | 5.1k 1% | Resistor_SMD:R_0603_1608Metric | 2 | BOT | GND
R6 | 267k 1% | Resistor_SMD:R_0603_1608Metric | 1 | TOP | FSW_BOOST
R6 | 267k 1% | Resistor_SMD:R_0603_1608Metric | 2 | BOT | SW_BOOST
R7 | 64.9k 1% | Resistor_SMD:R_0603_1608Metric | 1 | TOP | ILIM_BOOST
R7 | 64.9k 1% | Resistor_SMD:R_0603_1608Metric | 2 | BOT | GND
R8 | 10.5k 1% | Resistor_SMD:R_0603_1608Metric | 1 | TOP | COMP_BOOST
R8 | 10.5k 1% | Resistor_SMD:R_0603_1608Metric | 2 | BOT | GND
R1 | 169k 1% | Resistor_SMD:R_0603_1608Metric | 1 | TOP | +5V_BOOST
R1 | 169k 1% | Resistor_SMD:R_0603_1608Metric | 2 | BOT | FB_BOOST
R2 | 53.6k 1% | Resistor_SMD:R_0603_1608Metric | 1 | TOP | FB_BOOST
R2 | 53.6k 1% | Resistor_SMD:R_0603_1608Metric | 2 | BOT | GND
R13 | 267k 1% | Resistor_SMD:R_0603_1608Metric | 1 | TOP | VSET
R13 | 267k 1% | Resistor_SMD:R_0603_1608Metric | 2 | BOT | GND
C11 | 10uF 25V | Capacitor_SMD:C_1206_3216Metric | 1 | P | VBUS
C11 | 10uF 25V | Capacitor_SMD:C_1206_3216Metric | 2 | N | GND
C4 | 100nF | Capacitor_SMD:C_0603_1608Metric | 1 | P | LDO
C4 | 100nF | Capacitor_SMD:C_0603_1608Metric | 2 | N | GND
C1 | 10uF 10V | Capacitor_SMD:C_1206_3216Metric | 1 | P | VBAT
C1 | 10uF 10V | Capacitor_SMD:C_1206_3216Metric | 2 | N | GND
C7 | 1uF 16V | Capacitor_SMD:C_0603_1608Metric | 1 | P | VCC_BOOST
C7 | 1uF 16V | Capacitor_SMD:C_0603_1608Metric | 2 | N | GND
C6 | 100nF | Capacitor_SMD:C_0603_1608Metric | 1 | P | BOOT_BOOST
C6 | 100nF | Capacitor_SMD:C_0603_1608Metric | 2 | N | SW_BOOST
C8 | 10nF | Capacitor_SMD:C_0603_1608Metric | 1 | P | SS_BOOST
C8 | 10nF | Capacitor_SMD:C_0603_1608Metric | 2 | N | GND
C2 | 22uF 16V | Capacitor_SMD:C_1206_3216Metric | 1 | P | +5V_BOOST
C2 | 22uF 16V | Capacitor_SMD:C_1206_3216Metric | 2 | N | GND
C17 | 22uF 16V | Capacitor_SMD:C_1206_3216Metric | 1 | P | +5V_BOOST
C17 | 22uF 16V | Capacitor_SMD:C_1206_3216Metric | 2 | N | GND
C5 | 2.2nF | Capacitor_SMD:C_0603_1608Metric | 1 | P | COMP_BOOST
C5 | 2.2nF | Capacitor_SMD:C_0603_1608Metric | 2 | N | GND
C13 | 10uF 10V | Capacitor_SMD:C_1206_3216Metric | 1 | P | VBAT
C13 | 10uF 10V | Capacitor_SMD:C_1206_3216Metric | 2 | N | GND
C14 | 22uF 6.3V | Capacitor_SMD:C_1206_3216Metric | 1 | P | +3V3
C14 | 22uF 6.3V | Capacitor_SMD:C_1206_3216Metric | 2 | N | GND
C9 | 10nF | Capacitor_SMD:C_0603_1608Metric | 1 | P | CT_SOC
C9 | 10nF | Capacitor_SMD:C_0603_1608Metric | 2 | N | GND
C15 | 470uF 10V | Capacitor_SMD:CP_Elec_8x10 | 1 | P | +5V_SOC
C15 | 470uF 10V | Capacitor_SMD:CP_Elec_8x10 | 2 | N | GND
C16 | 10nF | Capacitor_SMD:C_0603_1608Metric | 1 | P | CT_MODEM
C16 | 10nF | Capacitor_SMD:C_0603_1608Metric | 2 | N | GND
C3 | 470uF 10V | Capacitor_SMD:CP_Elec_8x10 | 1 | P | +5V_MODEM
C3 | 470uF 10V | Capacitor_SMD:CP_Elec_8x10 | 2 | N | GND
