xuanvuong1702/flytex-camera/tools/measure/samples/g0-template.csv

id | date | board_rev | condition | instrument | quantity | value | unit | uncertainty_pct | pass_fail | notes
M-01 |  |  |  |  | power |  | W |  | NA | Cong suat tung trang thai S0-S3, co va khong co IR
M-02 |  |  |  |  | current |  | mA |  | NA | Dong ngu Eco trung binh 24 gio, muc tieu < 1 mA
M-03 |  |  |  |  | current |  | mA |  | NA | Dong va do tre lenh cua Watch; them dong latency neu can
M-30 |  |  |  |  | bandwidth |  | Mbps |  | NA | Bang thong tai len 4G, ba nha mang
M-31 |  |  |  |  | latency |  | s |  | NA | Do tre xem truc tiep qua relay, muc tieu <= 1.5 s
M-32 |  |  |  |  | boolean |  | bool |  | NA | eDRX/PSM duoc mang chap nhan: 1 = co, 0 = khong
