xuanvuong1702/flytex-camera/tools/measure/samples/ppk2-example.csv

# DU LIEU MINH HOA - KHONG PHAI SO DO THAT. Dung de kiem tra tools/measure ppk2.
Time (s) | Current (mA) | Voltage (V)
0 | 0,30 | 3,70
10 | 0,30 | 3,70
20 | 0,32 | 3,70
30 | 1,20 | 3,68
40 | 1,20 | 3,68
50 | 0,31 | 3,70
60 | 0,30 | 3,70
