xuanvuong1702/flytex-camera/hardware/kicad/flytex-cmp-full.pdf

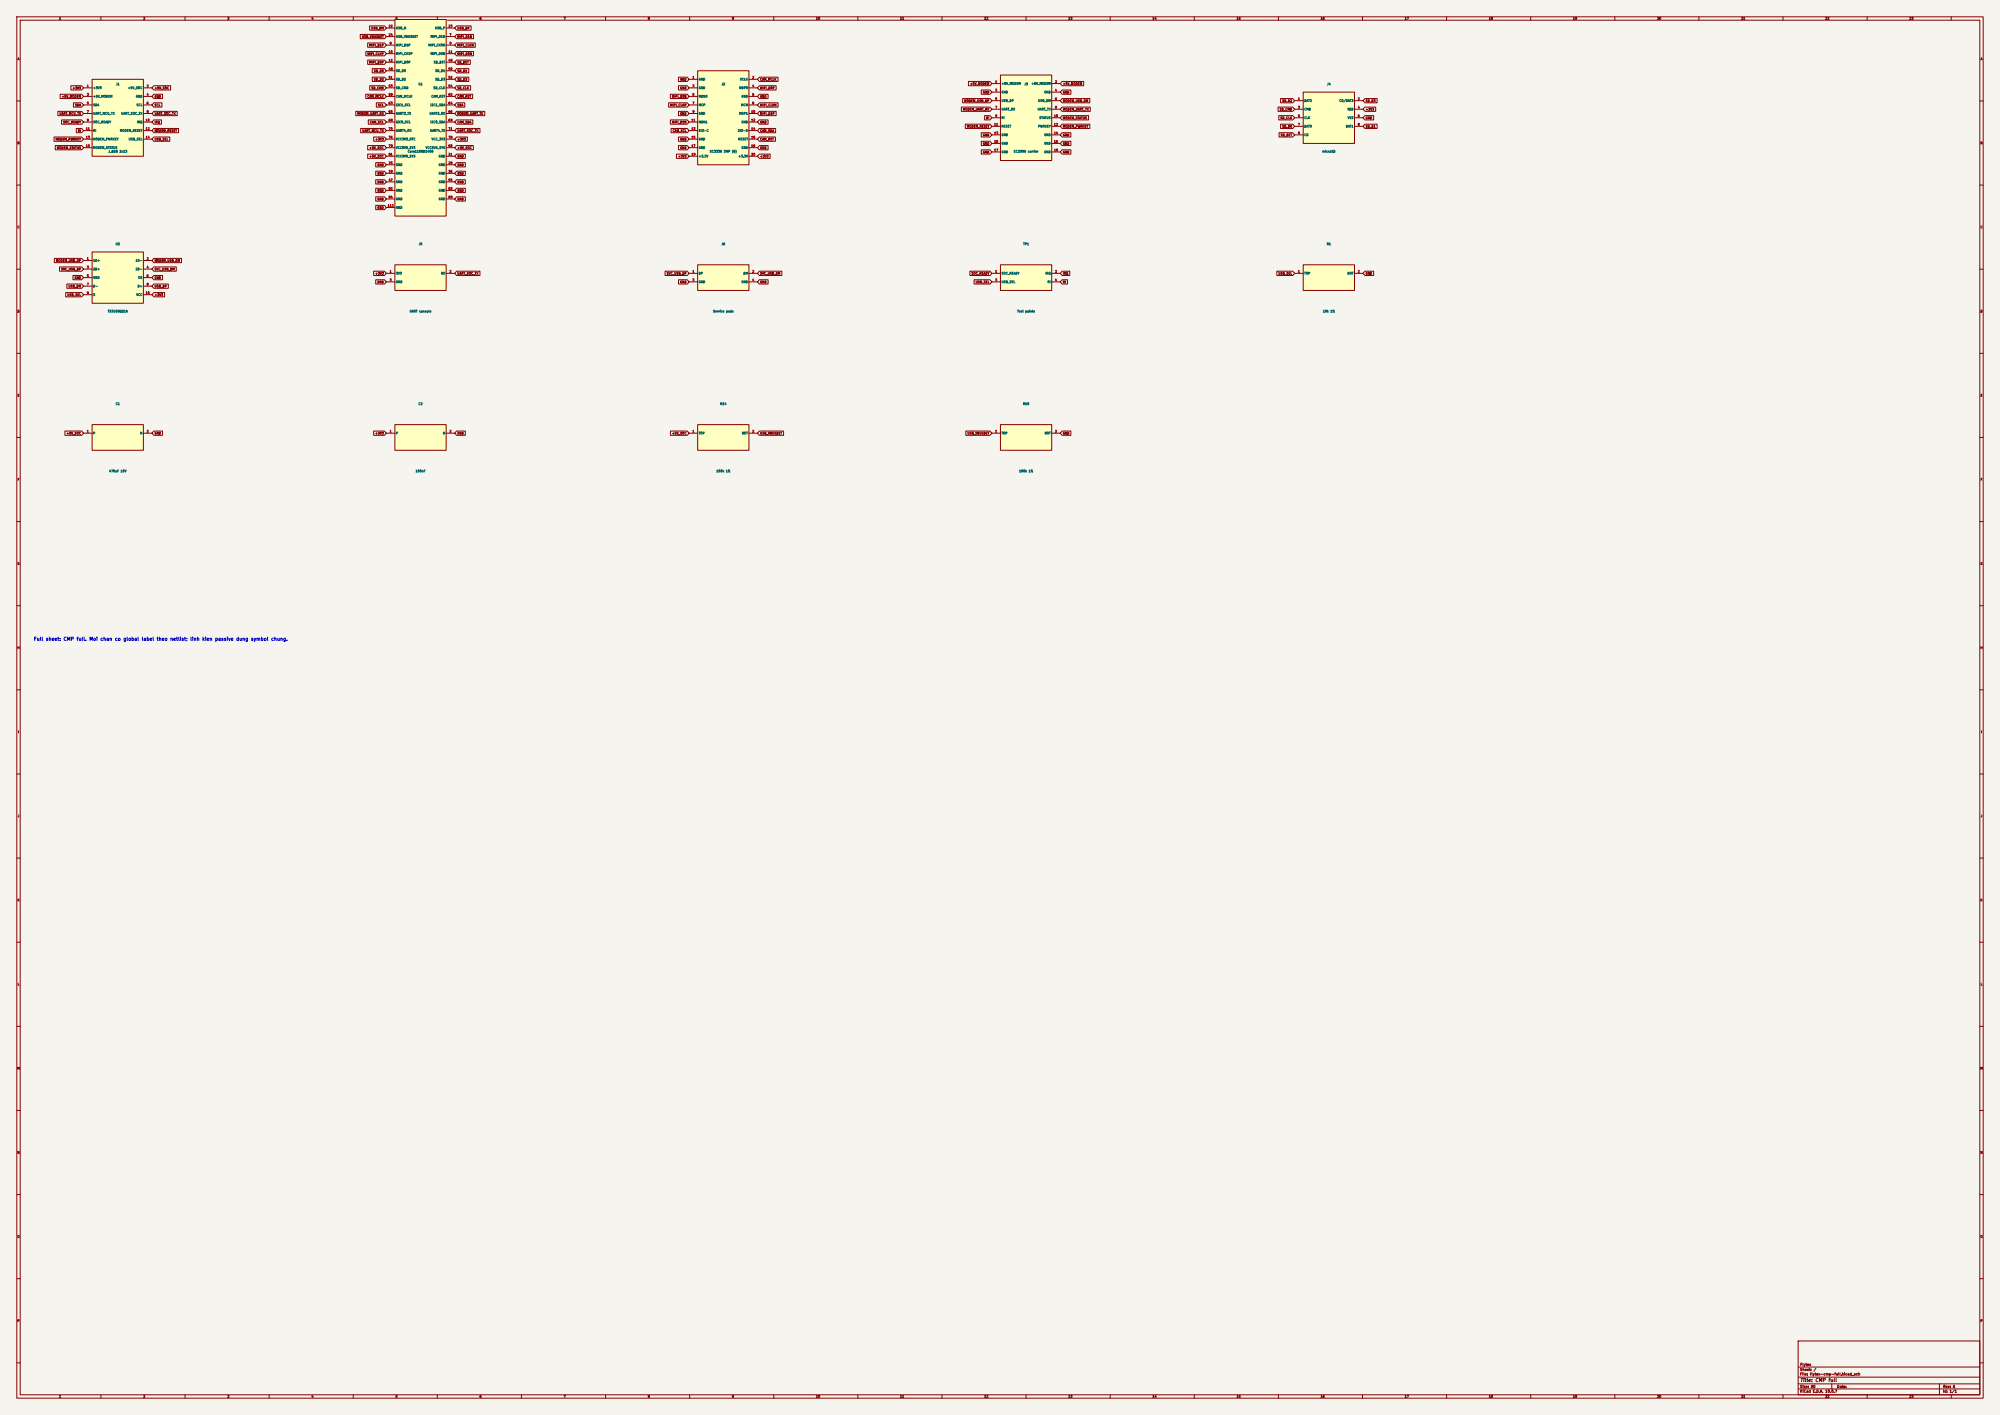
[picture p6: page 1]

Full sheet: CMP full. Moi chan co global label theo netlist; linh kien passive dung symbol chung.

Flytex
Sheet: /
File: flytex-cmp-full.kicad_sch
Title: CMP full

Size: A0 | Rev: A
KiCad E.D.A. 10.0.7 | Id: 1/1
