xuanvuong1702/flytex-camera/hardware/kicad/flytex-pwr-full.pdf

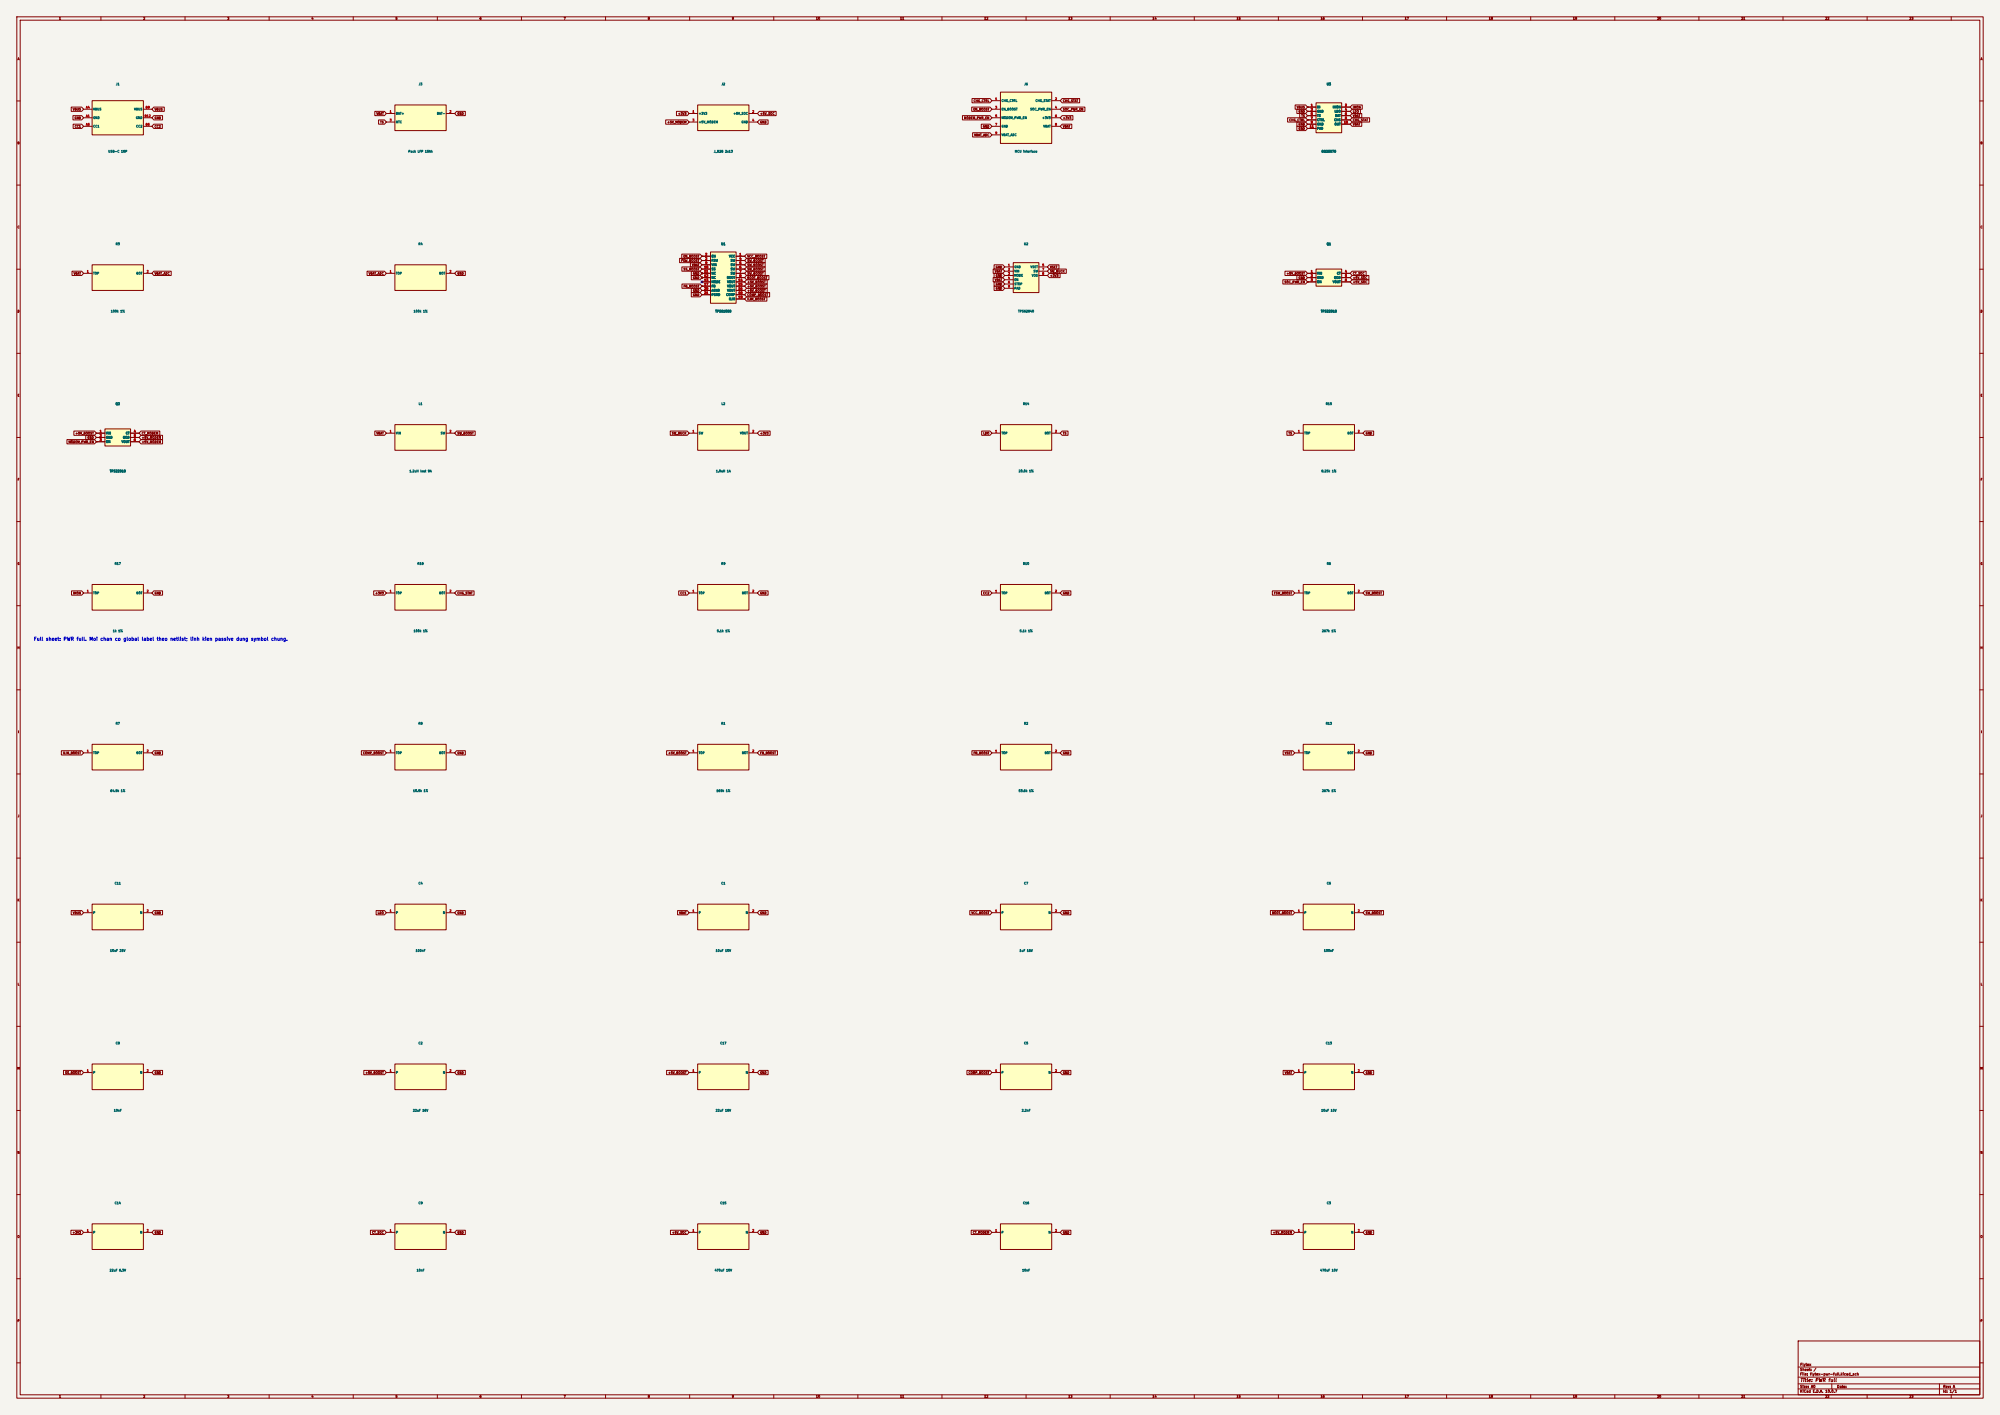
[picture p7: page 1]

GND Full sheet: PWR full. Moi chan co global label theo netlist; linh kien passive dung symbol chung.

Flytex
Sheet: /
File: flytex-pwr-full.kicad_sch
Title: PWR full

Size: A0 | Rev: A
KiCad E.D.A. 10.0.7 | Id: 1/1
