xuanvuong1702/flytex-camera/hardware/kicad/flytex-pwr.pdf

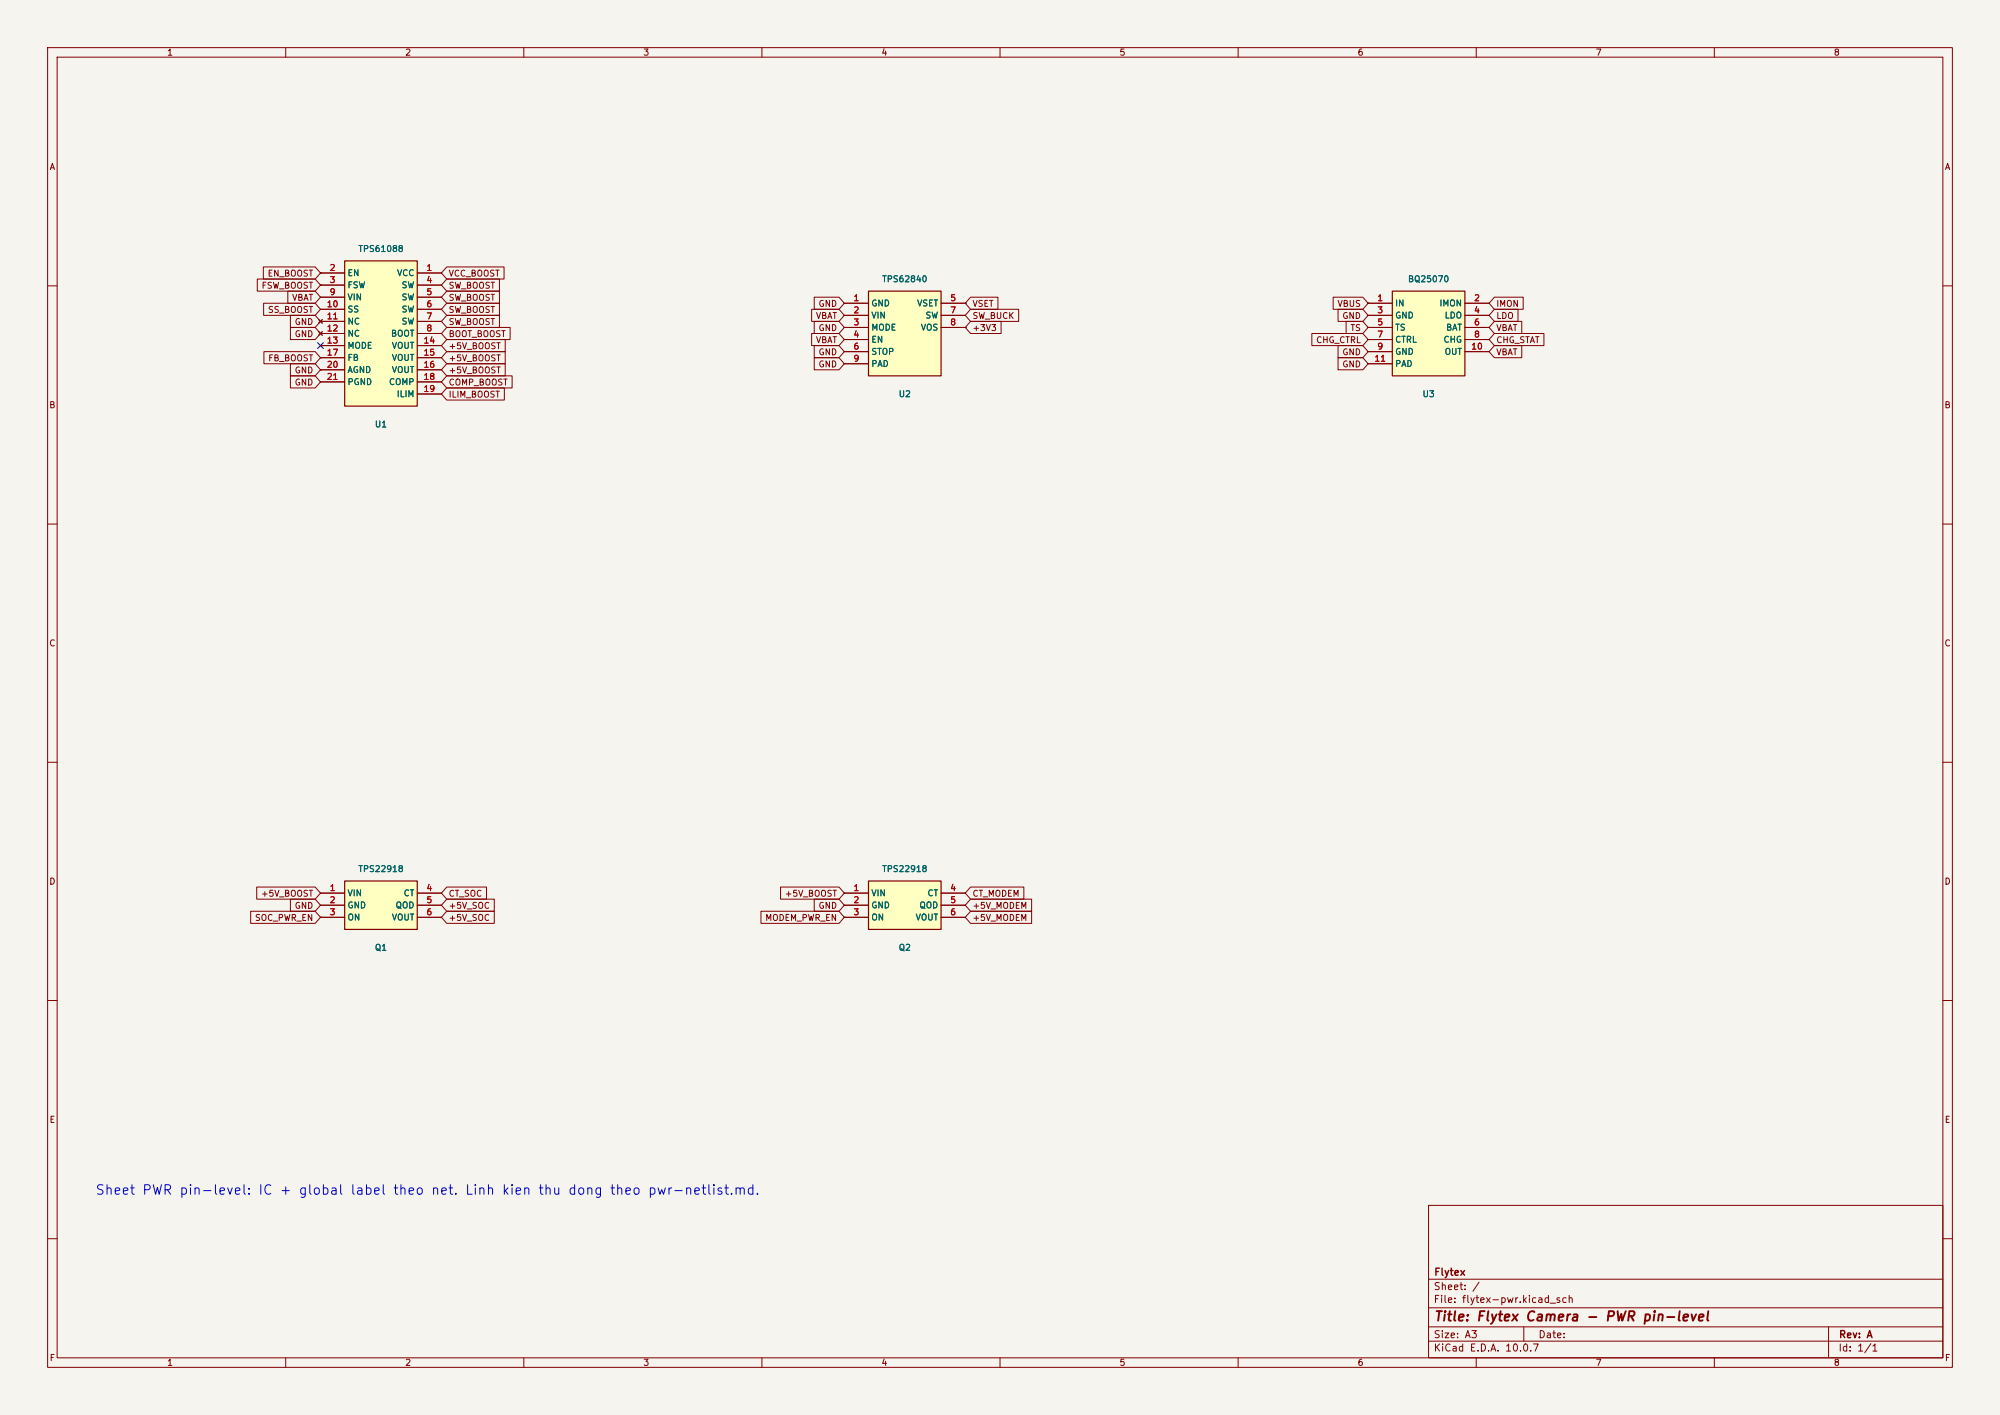
[picture p8: page 1]

GND Sheet PWR pin-level: IC + global label theo net. Linh kien thu dong theo pwr-netlist.md.

Flytex
Sheet: /
File: flytex-pwr.kicad_sch
Title: Flytex Camera - PWR pin-level

Size: A3 | Rev: A | F Date:
KiCad E.D.A. 10.0.7 | Id: 1/1
