xuanvuong1702/flytex-camera/hardware/kicad/flytex-cmp-full.kicad_sch

## KiCad design hardware/kicad/flytex-cmp-full.kicad_sch (2026-11-09)

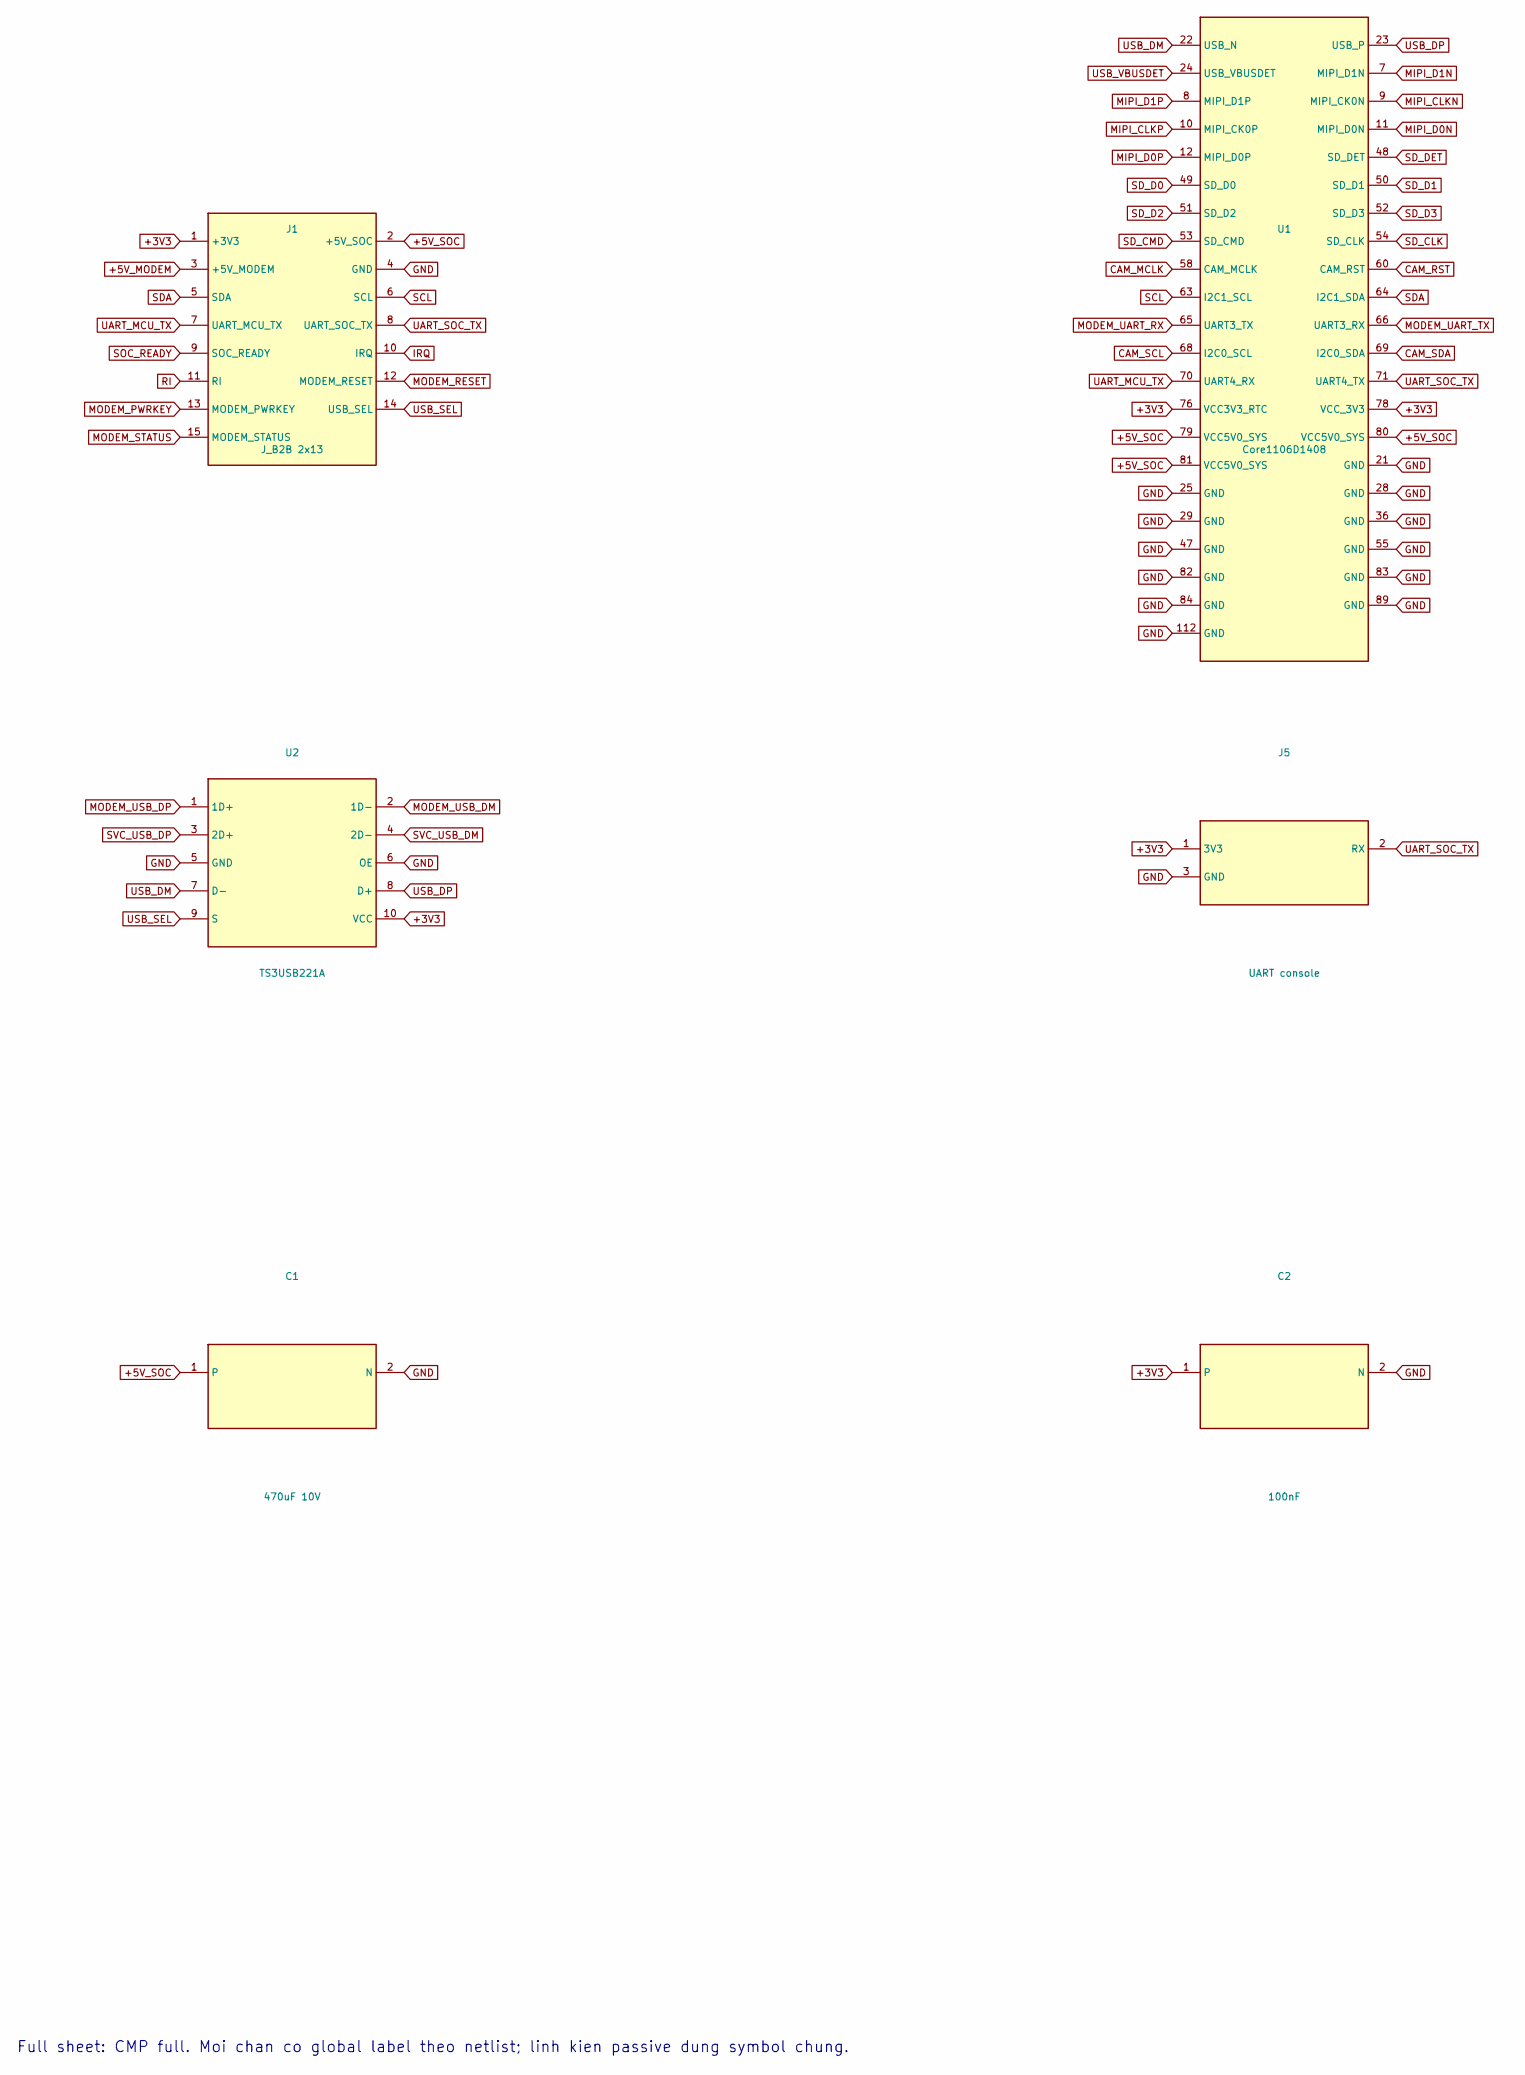
[picture p9: schematic flytex-cmp-full.kicad_sch, part in row 1, column 1]

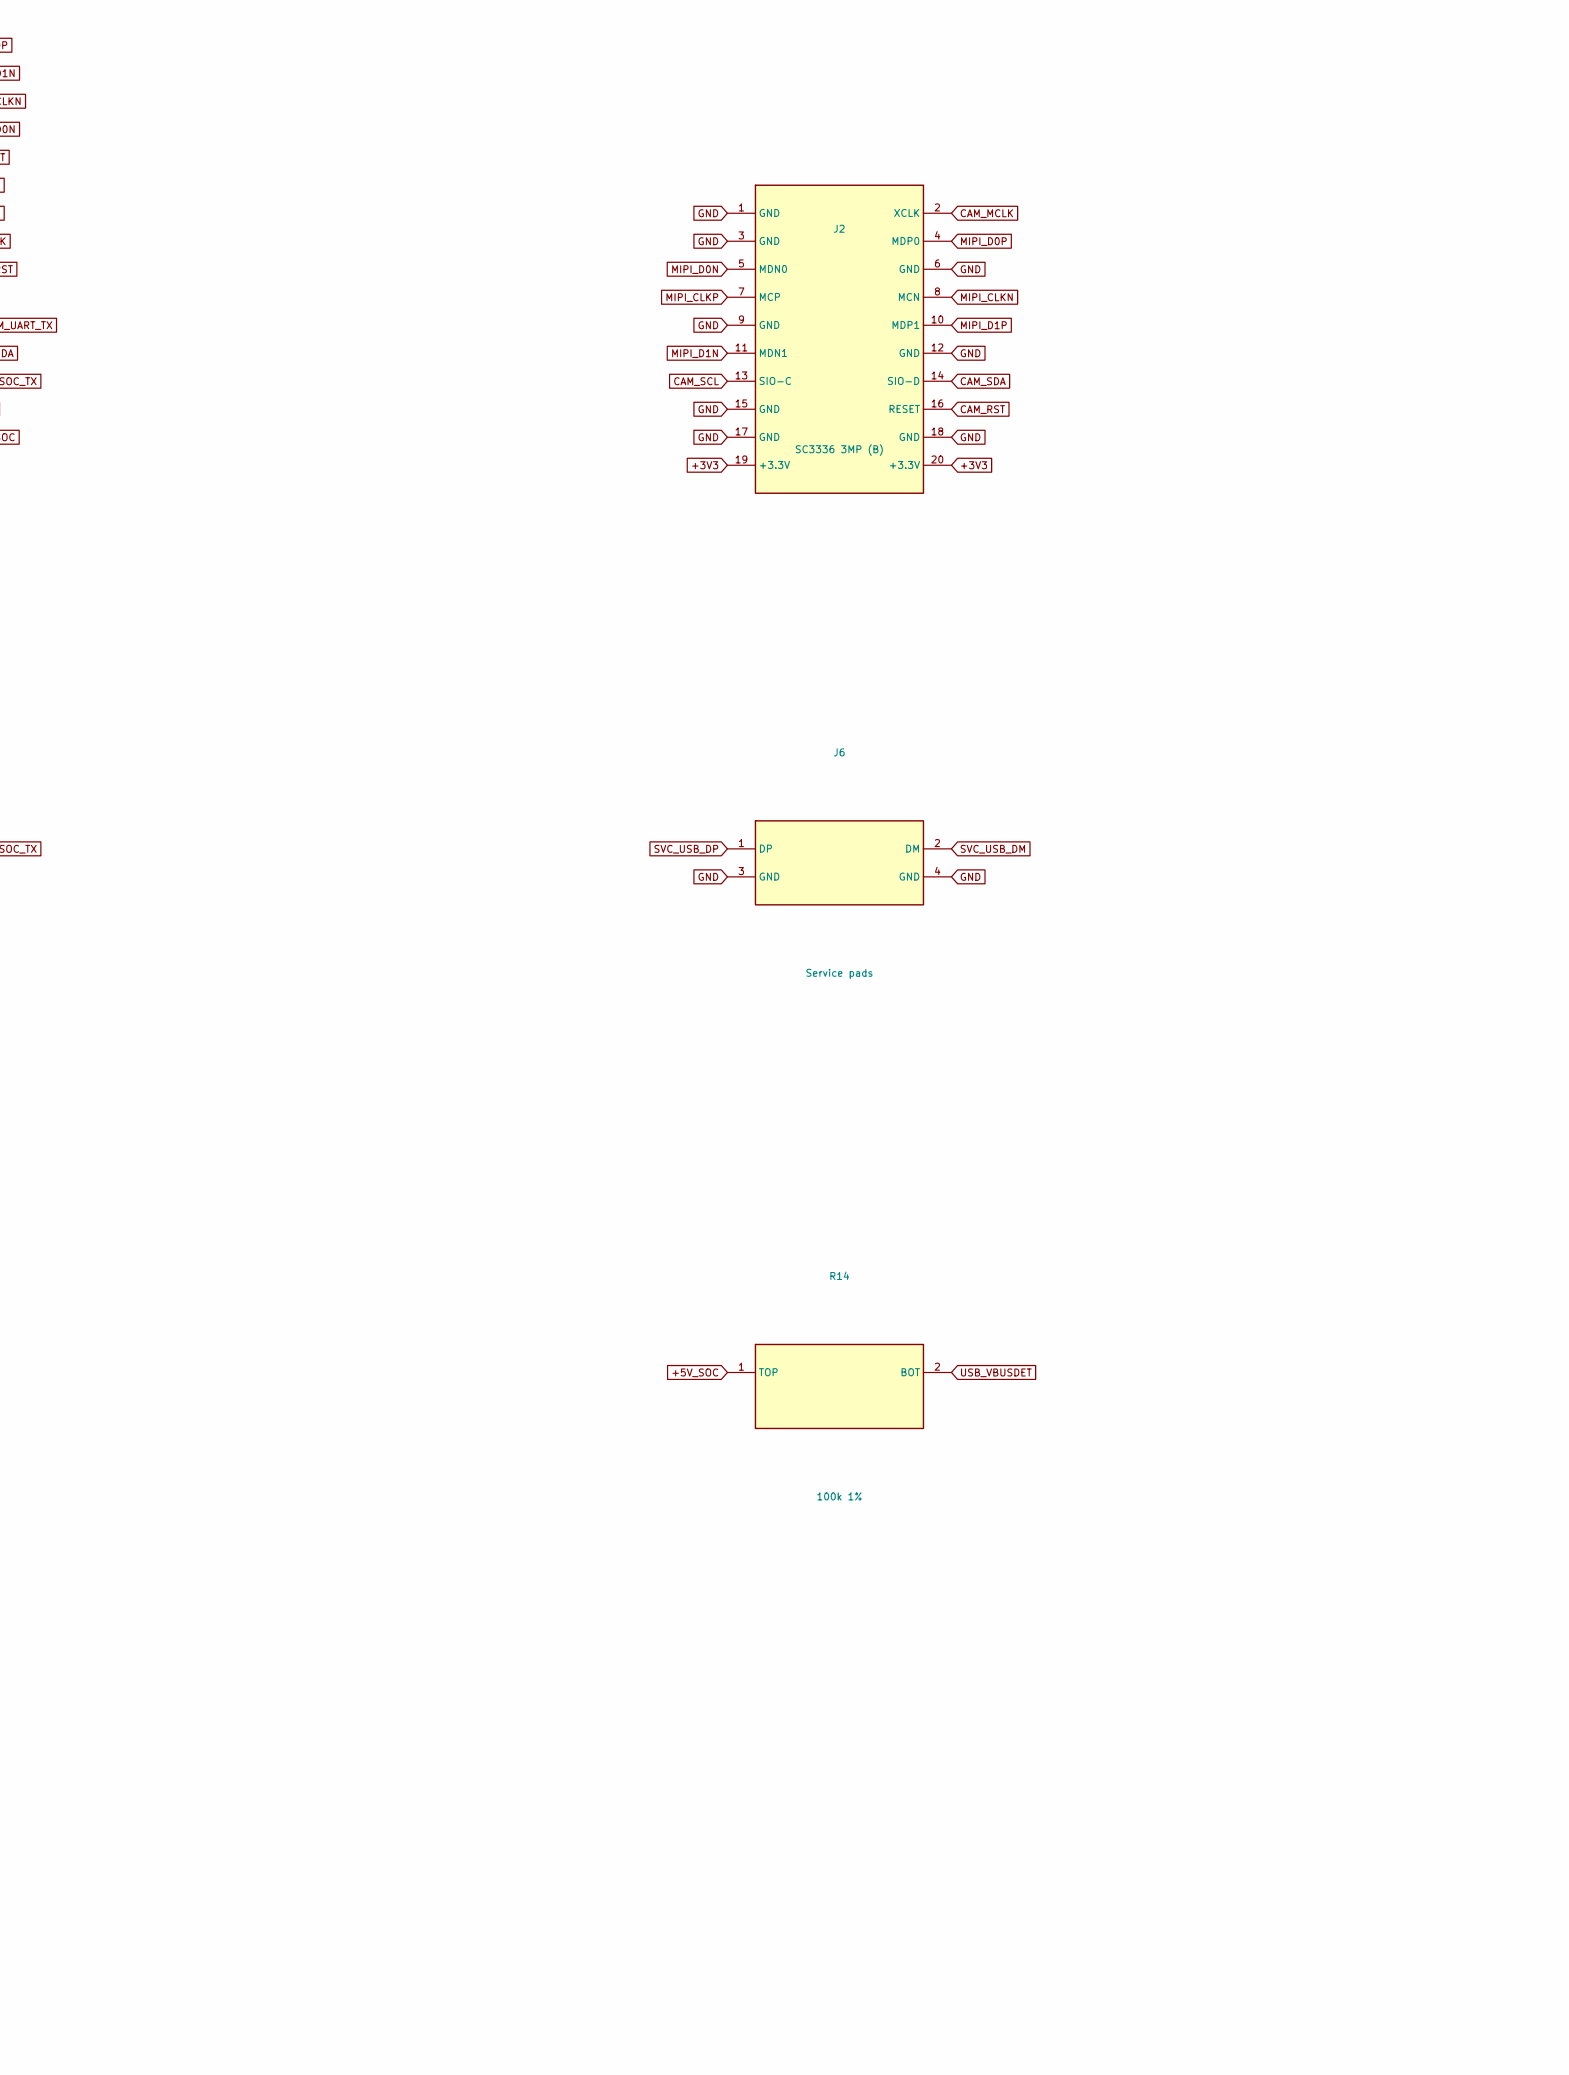
[picture p10: schematic flytex-cmp-full.kicad_sch, part in row 1, column 2]

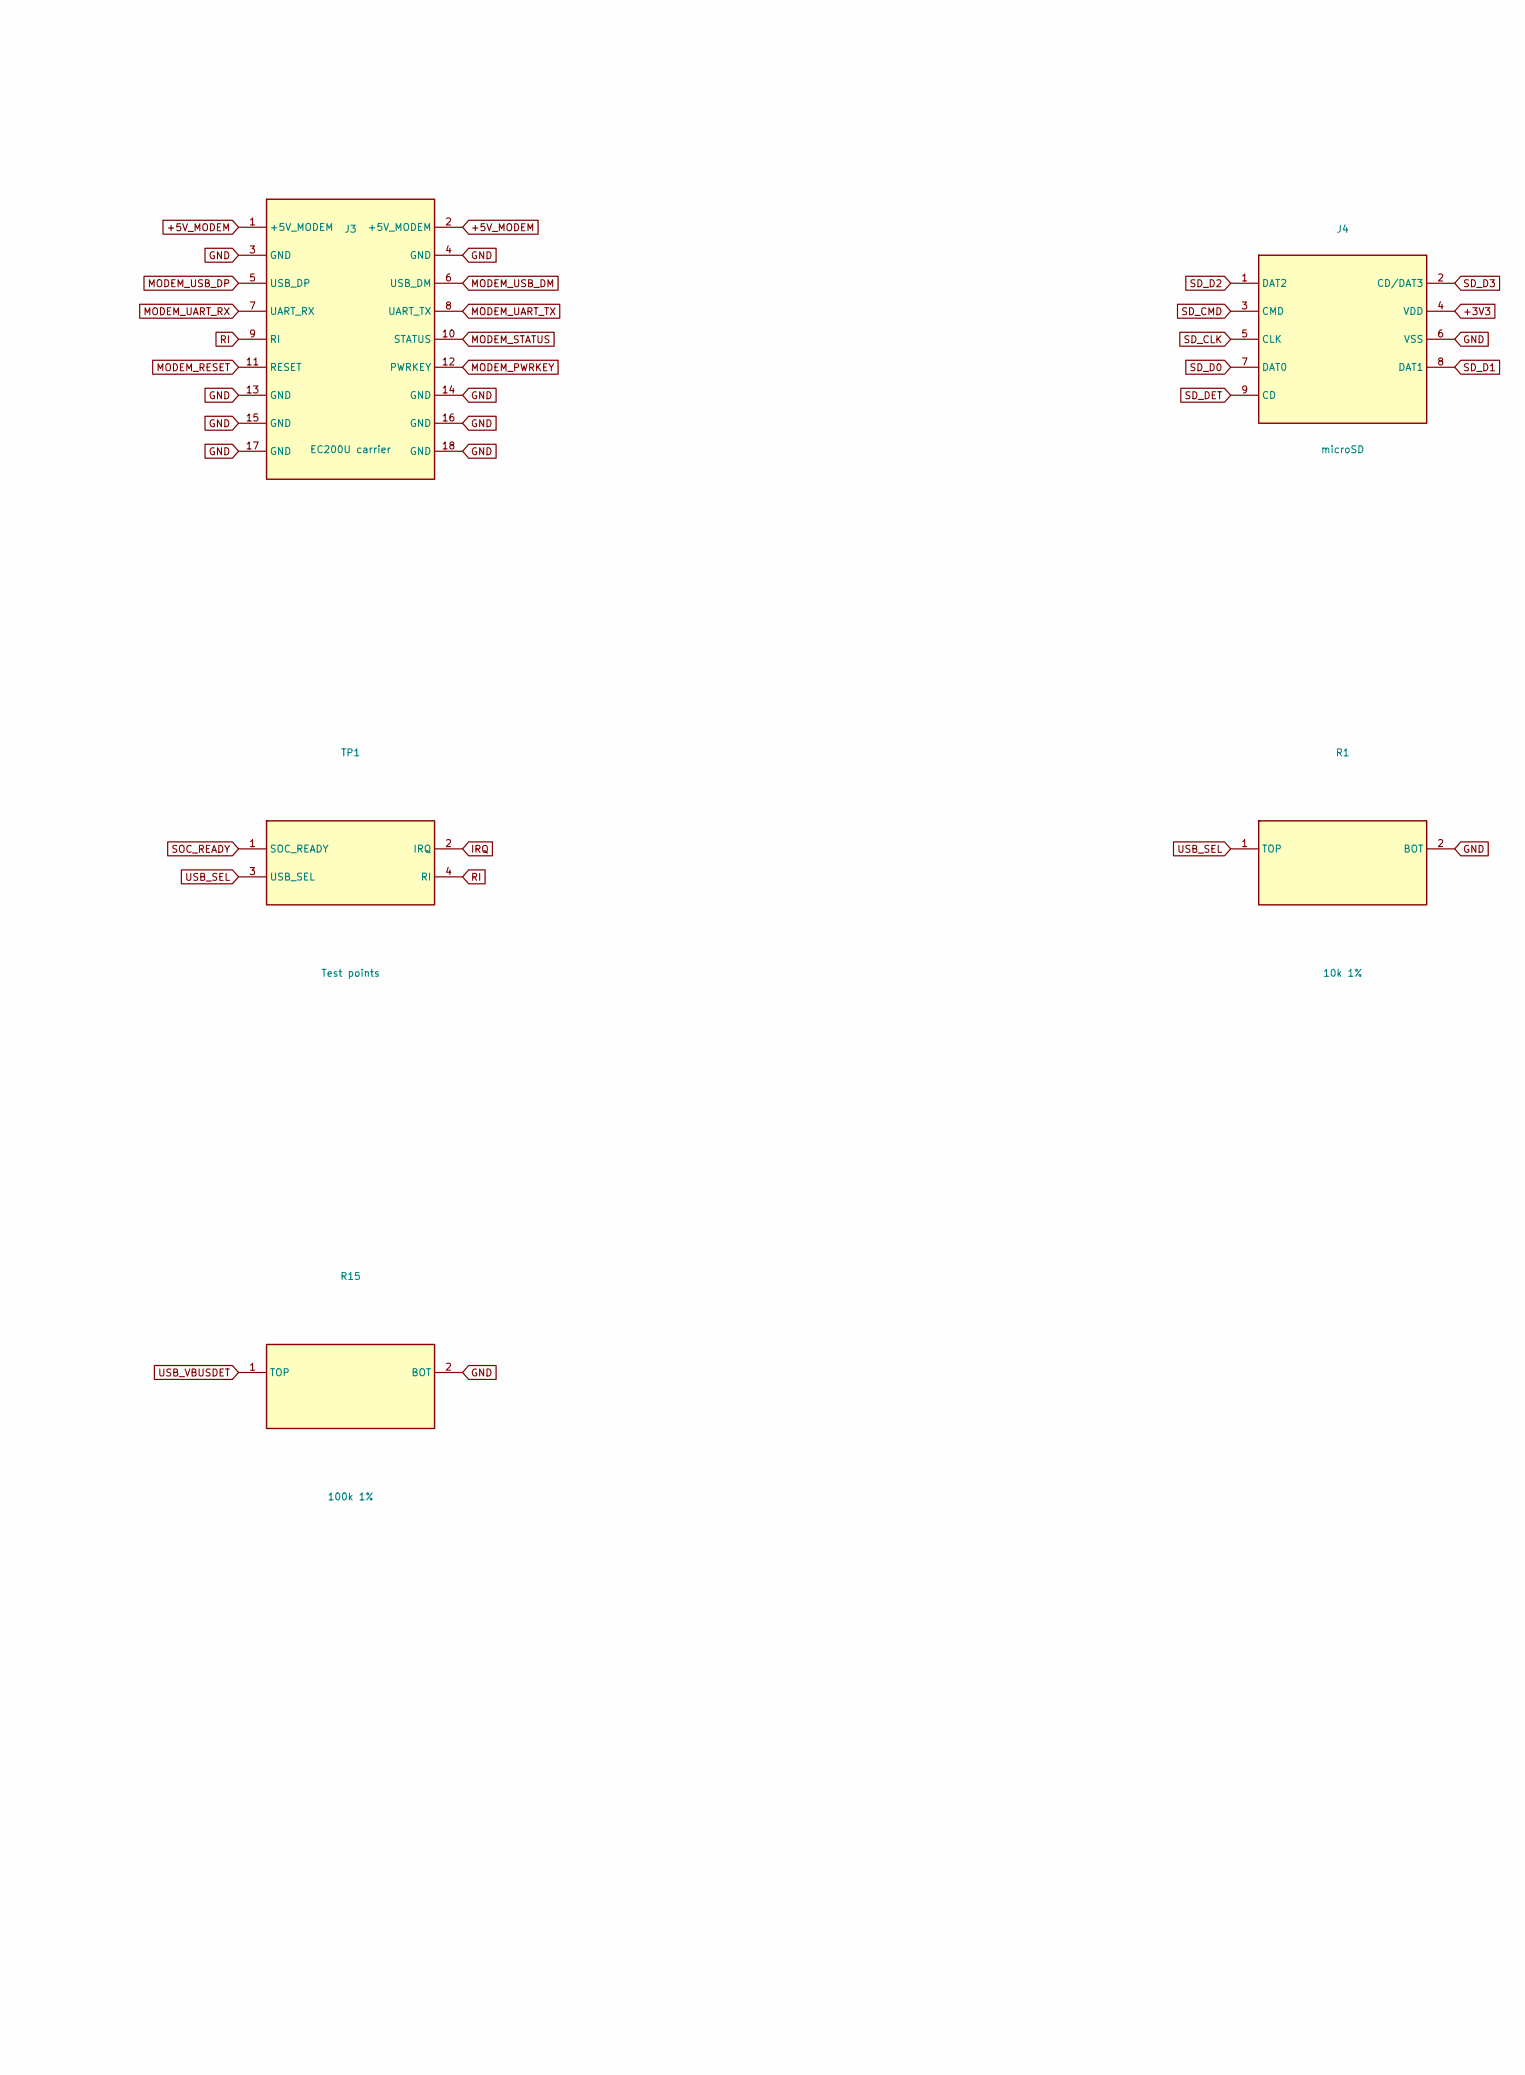
[picture p11: schematic flytex-cmp-full.kicad_sch, part in row 1, column 3]

Parts:
C1: 470uF 10V; CP_Elec_8x10
C2: 100nF; C_0603_1608Metric
J1: J_B2B 2x13; PinSocket_2x13_P2.54mm_Vertical
J2: SC3336 3MP (B); Hirose_FH12-20S-0.5SH_1x20-1MP_P0.50mm_Horizontal
J3: EC200U carrier; PinHeader_2x09_P2.54mm_Vertical
J4: microSD; microSD_HC_Hirose_DM3AT
J5: UART console; PinHeader_1x03_P2.54mm_Vertical
J6: Service pads; Conn_01x04
R1: 10k 1%; R_0603_1608Metric
R14, R15: 100k 1%; R_0603_1608Metric
TP1: Test points; Conn_01x04
U1: Core1106D1408; Core1106D
U2: TS3USB221A; UQFN-10_1.4x1.8mm_P0.4mm

Connections:
+3V3: C2.1, J1.1 (+3V3), J2.19 (+3.3V), J2.20 (+3.3V), J4.4 (VDD), J5.1 (3V3), U1.76 (VCC3V3_RTC), U1.78 (VCC_3V3), U2.10 (VCC)
+5V_MODEM: J1.3 (+5V_MODEM), J3.1 (+5V_MODEM), J3.2 (+5V_MODEM)
+5V_SOC: C1.1, J1.2 (+5V_SOC), R14.1 (TOP), U1.79 (VCC5V0_SYS), U1.80 (VCC5V0_SYS), U1.81 (VCC5V0_SYS)
CAM_MCLK: J2.2 (XCLK), U1.58 (CAM_MCLK)
CAM_RST: J2.16 (RESET), U1.60 (CAM_RST)
CAM_SCL: J2.13 (SIO-C), U1.68 (I2C0_SCL)
CAM_SDA: J2.14 (SIO-D), U1.69 (I2C0_SDA)
GND: C1.2 (N), C2.2 (N), J1.4 (GND), J2.1 (GND), J2.3 (GND), J2.6 (GND), J2.9 (GND), J2.12 (GND), J2.15 (GND), J2.17 (GND), J2.18 (GND), J3.3 (GND), J3.4 (GND), J3.13 (GND), J3.14 (GND), J3.15 (GND), J3.16 (GND), J3.17 (GND), J3.18 (GND), J4.6 (VSS), J5.3 (GND), J6.3 (GND), J6.4 (GND), R1.2 (BOT), R15.2 (BOT), U1.21 (GND), U1.25 (GND), U1.28 (GND), U1.29 (GND), U1.36 (GND), U1.47 (GND), U1.55 (GND), U1.82 (GND), U1.83 (GND), U1.84 (GND), U1.89 (GND), U1.112 (GND), U2.5 (GND), U2.6 (OE)
IRQ: J1.10 (IRQ), TP1.2 (IRQ)
MIPI_CLKN: J2.8 (MCN), U1.9 (MIPI_CK0N)
MIPI_CLKP: J2.7 (MCP), U1.10 (MIPI_CK0P)
MIPI_D0N: J2.5 (MDN0), U1.11 (MIPI_D0N)
MIPI_D0P: J2.4 (MDP0), U1.12 (MIPI_D0P)
MIPI_D1N: J2.11 (MDN1), U1.7 (MIPI_D1N)
MIPI_D1P: J2.10 (MDP1), U1.8 (MIPI_D1P)
MODEM_PWRKEY: J1.13 (MODEM_PWRKEY), J3.12 (PWRKEY)
MODEM_RESET: J1.12 (MODEM_RESET), J3.11 (RESET)
MODEM_STATUS: J1.15 (MODEM_STATUS), J3.10 (STATUS)
MODEM_UART_RX: J3.7 (UART_RX), U1.65 (UART3_TX)
MODEM_UART_TX: J3.8 (UART_TX), U1.66 (UART3_RX)
MODEM_USB_DM: J3.6 (USB_DM), U2.2 (1D-)
MODEM_USB_DP: J3.5 (USB_DP), U2.1 (1D+)
RI: J1.11 (RI), J3.9 (RI), TP1.4 (RI)
SCL: J1.6 (SCL), U1.63 (I2C1_SCL)
SDA: J1.5 (SDA), U1.64 (I2C1_SDA)
SD_CLK: J4.5 (CLK), U1.54 (SD_CLK)
SD_CMD: J4.3 (CMD), U1.53 (SD_CMD)
SD_D0: J4.7 (DAT0), U1.49 (SD_D0)
SD_D1: J4.8 (DAT1), U1.50 (SD_D1)
SD_D2: J4.1 (DAT2), U1.51 (SD_D2)
SD_D3: J4.2 (CD/DAT3), U1.52 (SD_D3)
SD_DET: J4.9 (CD), U1.48 (SD_DET)
SOC_READY: J1.9 (SOC_READY), TP1.1 (SOC_READY)
SVC_USB_DM: J6.2 (DM), U2.4 (2D-)
SVC_USB_DP: J6.1 (DP), U2.3 (2D+)
UART_MCU_TX: J1.7 (UART_MCU_TX), U1.70 (UART4_RX)
UART_SOC_TX: J1.8 (UART_SOC_TX), J5.2 (RX), U1.71 (UART4_TX)
USB_DM: U1.22 (USB_N), U2.7 (D-)
USB_DP: U1.23 (USB_P), U2.8 (D+)
USB_SEL: J1.14 (USB_SEL), R1.1 (TOP), TP1.3 (USB_SEL), U2.9 (S)
USB_VBUSDET: R14.2 (BOT), R15.1 (TOP), U1.24 (USB_VBUSDET)

Notes on the sheet:
Full sheet: CMP full. Moi chan co global label theo netlist; linh kien passive dung symbol chung.
