xuanvuong1702/flytex-camera/hardware/kicad/flytex-pwr-full.kicad_sch

## KiCad design hardware/kicad/flytex-pwr-full.kicad_sch (2026-11-09)

Schematic: flytex-pwr-full.kicad_sch

Parts:
C1, C13: 10uF 10V; C_1206_3216Metric
C2, C17: 22uF 16V; C_1206_3216Metric
C3, C15: 470uF 10V; CP_Elec_8x10
C4, C6: 100nF; C_0603_1608Metric
C5: 2.2nF; C_0603_1608Metric
C7: 1uF 16V; C_0603_1608Metric
C8, C9, C16: 10nF; C_0603_1608Metric
C11: 10uF 25V; C_1206_3216Metric
C14: 22uF 6.3V; C_1206_3216Metric
J1: USB-C 16P; USB_C_Receptacle_USB2.0_16P
J2: J_B2B 2x13; Conn_02x13_Odd_Even
J3: Pack LFP 15Ah; AMASS_XT30PW-M_1x02_P2.50mm_Horizontal
J6: MCU interface; PinHeader_1x09_P2.54mm_Vertical
L1: 1.2uH Isat 9A; L_Vishay_IHLP-2525
L2: 1.0uH 1A; L_0603_1608Metric
Q1, Q2: TPS22918; SOT-23-6
R1: 169k 1%; R_0603_1608Metric
R2: 53.6k 1%; R_0603_1608Metric
R3, R4, R18: 100k 1%; R_0603_1608Metric
R6, R13: 267k 1%; R_0603_1608Metric
R7: 64.9k 1%; R_0603_1608Metric
R8: 10.5k 1%; R_0603_1608Metric
R9, R10: 5.1k 1%; R_0603_1608Metric
R14: 20.0k 1%; R_0603_1608Metric
R15: 8.25k 1%; R_0603_1608Metric
R17: 1k 1%; R_0603_1608Metric
U1: TPS61088; Texas_VQFN-RHL-20
U2: TPS62840; VSON-8_1.5x2mm_P0.5mm
U3: BQ25070; TI_DQC0010A

Connections:
+3V3: C14.1, J2.1 (+3V3), J6.6 (+3V3), L2.2 (VOUT), R18.1 (TOP), U2.8 (VOS)
+5V_BOOST: C2.1, C17.1, Q1.1 (VIN), Q2.1 (VIN), R1.1 (TOP), U1.14 (VOUT), U1.15 (VOUT), U1.16 (VOUT)
+5V_MODEM: C3.1, J2.3 (+5V_MODEM), Q2.5 (QOD), Q2.6 (VOUT)
+5V_SOC: C15.1, J2.2 (+5V_SOC), Q1.5 (QOD), Q1.6 (VOUT)
BOOT_BOOST: C6.1, U1.8 (BOOT)
CC1: J1.A5 (CC1), R9.1 (TOP)
CC2: J1.B5 (CC2), R10.1 (TOP)
CHG_CTRL: J6.1 (CHG_CTRL), U3.7 (CTRL)
CHG_STAT: J6.2 (CHG_STAT), R18.2 (BOT), U3.8 (CHG)
COMP_BOOST: C5.1, R8.1 (TOP), U1.18 (COMP)
CT_MODEM: C16.1, Q2.4 (CT)
CT_SOC: C9.1, Q1.4 (CT)
EN_BOOST: J6.3 (EN_BOOST), U1.2 (EN)
FB_BOOST: R1.2 (BOT), R2.1 (TOP), U1.17 (FB)
FSW_BOOST: R6.1 (TOP), U1.3 (FSW)
GND: C1.2 (N), C2.2 (N), C3.2 (N), C4.2 (N), C5.2 (N), C7.2 (N), C8.2 (N), C9.2 (N), C11.2 (N), C13.2 (N), C14.2 (N), C15.2 (N), C16.2 (N), C17.2 (N), J1.A1 (GND), J1.B12 (GND), J2.4 (GND), J3.2 (BAT-), J6.7 (GND), Q1.2 (GND), Q2.2 (GND), R2.2 (BOT), R4.2 (BOT), R7.2 (BOT), R8.2 (BOT), R9.2 (BOT), R10.2 (BOT), R13.2 (BOT), R15.2 (BOT), R17.2 (BOT), U1.11 (NC), U1.12 (NC), U1.20 (AGND), U1.21 (PGND), U2.1 (GND), U2.3 (MODE), U2.6 (STOP), U2.9 (PAD), U3.3 (GND), U3.9 (GND), U3.11 (PAD)
ILIM_BOOST: R7.1 (TOP), U1.19 (ILIM)
IMON: R17.1 (TOP), U3.2 (IMON)
LDO: C4.1, R14.1 (TOP), U3.4 (LDO)
MODEM_PWR_EN: J6.5 (MODEM_PWR_EN), Q2.3 (ON)
SOC_PWR_EN: J6.4 (SOC_PWR_EN), Q1.3 (ON)
SS_BOOST: C8.1, U1.10 (SS)
SW_BOOST: C6.2 (N), L1.2 (SW), R6.2 (BOT), U1.4 (SW), U1.5 (SW), U1.6 (SW), U1.7 (SW)
SW_BUCK: L2.1 (SW), U2.7 (SW)
TS: J3.3 (NTC), R14.2 (BOT), R15.1 (TOP), U3.5 (TS)
VBAT: C1.1, C13.1, J3.1 (BAT+), J6.8 (VBAT), L1.1 (VIN), R3.1 (TOP), U1.9 (VIN), U2.2 (VIN), U2.4 (EN), U3.6 (BAT), U3.10 (OUT)
VBAT_ADC: J6.9 (VBAT_ADC), R3.2 (BOT), R4.1 (TOP)
VBUS: C11.1, J1.A4 (VBUS), J1.B9 (VBUS), U3.1 (IN)
VCC_BOOST: C7.1, U1.1 (VCC)
VSET: R13.1 (TOP), U2.5 (VSET)

Notes on the sheet:
Full sheet: PWR full. Moi chan co global label theo netlist; linh kien passive dung symbol chung.
