xuanvuong1702/flytex-camera/hardware/kicad/flytex-pwr.kicad_sch

## KiCad design hardware/kicad/flytex-pwr.kicad_sch (2026-11-09)

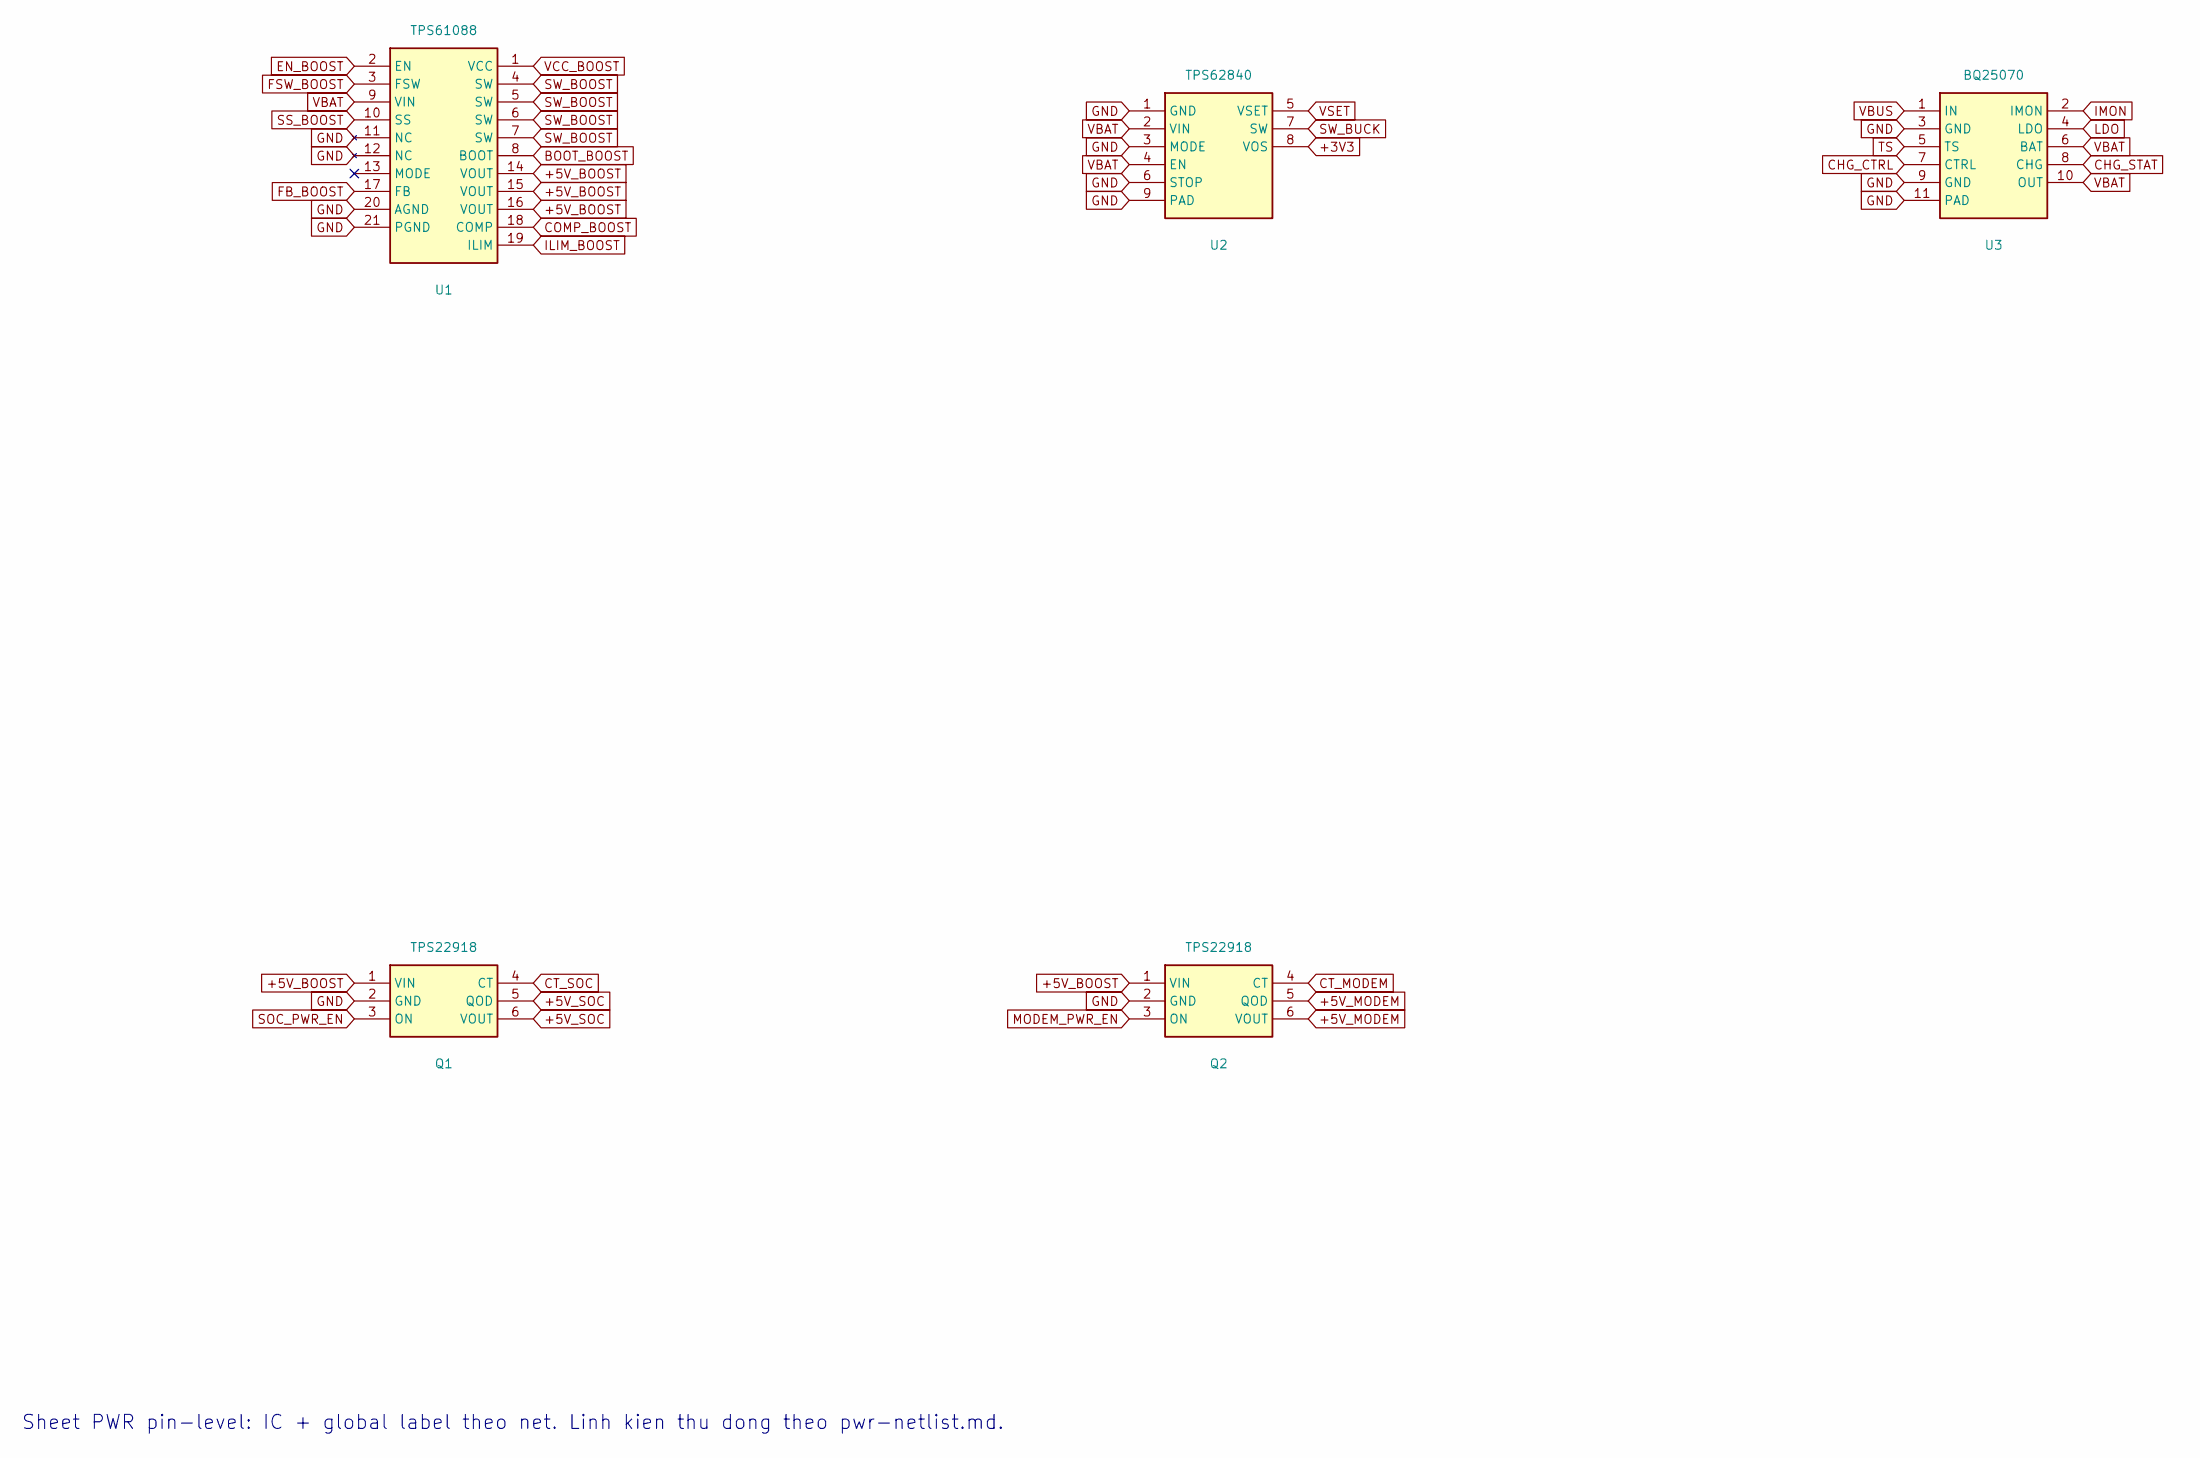
[picture p12: schematic flytex-pwr.kicad_sch]

Parts:
Q1, Q2: TPS22918; SOT-23-6
U1: TPS61088; Texas_VQFN-RHL-20
U2: TPS62840; VSON-8_1.5x2mm_P0.5mm
U3: BQ25070; TI_DQC0010A

Connections:
+3V3: U2.8 (VOS)
+5V_BOOST: Q1.1 (VIN), Q2.1 (VIN), U1.14 (VOUT), U1.15 (VOUT), U1.16 (VOUT)
+5V_MODEM: Q2.5 (QOD), Q2.6 (VOUT)
+5V_SOC: Q1.5 (QOD), Q1.6 (VOUT)
BOOT_BOOST: U1.8 (BOOT)
CHG_CTRL: U3.7 (CTRL)
CHG_STAT: U3.8 (CHG)
COMP_BOOST: U1.18 (COMP)
CT_MODEM: Q2.4 (CT)
CT_SOC: Q1.4 (CT)
EN_BOOST: U1.2 (EN)
FB_BOOST: U1.17 (FB)
FSW_BOOST: U1.3 (FSW)
GND: Q1.2 (GND), Q2.2 (GND), U1.11 (NC), U1.12 (NC), U1.20 (AGND), U1.21 (PGND), U2.1 (GND), U2.3 (MODE), U2.6 (STOP), U2.9 (PAD), U3.3 (GND), U3.9 (GND), U3.11 (PAD)
ILIM_BOOST: U1.19 (ILIM)
IMON: U3.2 (IMON)
LDO: U3.4 (LDO)
MODEM_PWR_EN: Q2.3 (ON)
SOC_PWR_EN: Q1.3 (ON)
SS_BOOST: U1.10 (SS)
SW_BOOST: U1.4 (SW), U1.5 (SW), U1.6 (SW), U1.7 (SW)
SW_BUCK: U2.7 (SW)
TS: U3.5 (TS)
VBAT: U1.9 (VIN), U2.2 (VIN), U2.4 (EN), U3.6 (BAT), U3.10 (OUT)
VBUS: U3.1 (IN)
VCC_BOOST: U1.1 (VCC)
VSET: U2.5 (VSET)

Notes on the sheet:
Sheet PWR pin-level: IC + global label theo net. Linh kien thu dong theo pwr-netlist.md.
