xuanvuong1702/flytex-camera/(commit log)

2026-11-09 Phan tich kha thi, dac ta sinh tu spec, firmware MCU, ung dung Linux, mo phong, tinh toan PWR
    - docs/13 phan tich kha thi: 9 loi thiet ke, so lieu kiem lai, chi phi, tien do
    - spec/regmap, b2b, mqtt sinh C/Python/MD/JSON schema (29 test)
    - firmware MCU C + HAL host + FFI (59 test), port STM32L0 khung
    - ung dung Linux Python: power, modem, recorder, uplink, cloud, commands (125 test)
    - sim/ end-to-end dung firmware C that qua ctypes (5 kich ban)
    - tools/measure + docs_check (108 test), CI, systemd, BOM G0
    - hardware/calc tinh toan PWR Rev A + hardware/pwr-design.md (28 test)
    - chot D-16, D-18, D-19, D-21
    [g0-example.csv, g0-template.csv, pinout_pwr_cmp.csv]
2026-11-09 MPEG-TS muxer, tai clip HTTPS, OTA A/B co xac minh, nhap PPK2, dinh nghia san sang prototype
    - app/flytex/tsmux.py: MPEG-TS H.264 (PAT/PMT/PCR/PTS), 14 test voi parser doc lap
    - app/flytex/upload.py: PUT presigned URL + UploadSpool ben, 13 test gom HTTP server that
    - app/flytex/ota.py: stage/activate/check_boot/rollback, bat buoc verifier, 17 test
    - service: noi uploader/spool/ota, clip_ready sau khi tai, ota.start co handler
    - tools/measure/ppk2.py: nhap CSV PPK2, tich phan dien luong/nang luong, them trang thai INFO
    - docs/17 dinh nghia dieu kien san sang prototype va bien ban 3 vong kiem tra
    - cap nhat docs/04, 08, 13, 14, 15; 408 test, 27/27 buoc
    [ppk2-example.csv]
2026-11-09 Vong kiem tra 1: sua upload chan luong chinh, doc SMS danh thuc, them BOM Rev A/B, sua goi linh kien
    - upload chay trong luong nen + Event; step khong chan; cho toi da 5s khi ngu
    - DeviceService doc SMS danh thuc va so token (wake_token trong Config)
    - them hardware/bom (PWR Rev A, CMP Rev B) + test 8 muc + quy tac xac minh
    - sua goi: TPS62840 DLC = SOT-563; STM32L031G6 = UFQFPN-28; M24C32-FMN6TP = TSSOP-8
    - dinh chinh docs/02, checklist footprint; sim dung TsMuxer
    - docs/17 ghi vong 1 va 6 phat hien
    [cmp-rev-b.csv, pwr-rev-a.csv]
2026-11-09 Ba vong kiem tra lien tiep dat: du dieu kien dung prototype
    - docs/17 ghi vong 1 (6 phat hien), vong 3 (1 phat hien), vong 4-6 dat lien tiep
    - sua nhat quan nhiet vo 12.8 K / 57.8 do C, tro ve pwr-design
    - README cap nhat trang thai san sang, so test 430, 31 buoc
    - ket luan: du dieu kien dung prototype; con lai la Gerber/footprint/do that/chung nhan
2026-11-09 Ra soat tai lieu linh kien: so dang ky, doi chieu thiet ke, 6 blocker truoc khi mua
    - spec/parts.toml: 14 linh kien + 4 module, datasheet URL, thong so, muc xac minh
    - hardware/parts: kiem tra thiet ke, sinh parts-register.md, --strict lam cong truoc khi dat
    - phat hien: thieu dien tro hoi tiep buck; chua xac nhan LFP cho BQ25798; thieu RI breakout; chua nap pinout Core1106D; chua chon camera; chua co pack/BMS
    - docs/18: phan tich linh kien, sai lech da sua, toi uu de xuat
    - docs/19: tai lieu/phan tich con thieu theo tung cong truoc khi mua va thu
    - cap nhat BOM/readiness/run_tests: 440 test, 33/33 buoc
2026-11-09 Sua loi ra soat doc lap: CI gcc, goi linh kien, loai BQ25798, mo lai ket luan prototype
    - them <stddef.h> cho 4 file nguon + 3 header + test; them lint include C vao CI
    - khoi phuc goi dung: TPS62840 SON-8 1.5x2, M24C32 SO-8; chi STM32 UFQFPN-28 la dung
    - loai BQ25798 (mac dinh 4.2V + watchdog 40s); chuyen sang yeu cau IC float LFP 3.6V bang phan cung
    - tam hoan muc NTC 7.15k trong pwr-design; viet lai docs/02 §5-6
    - +3V3 ghi ro 3.0-3.3V; them O-16
    - BOM: them Rfsw/Rilim/COMP/boot/VCC/SS, Rd USB-C, TVS VBUS, CT load switch; sua 169k/53.6k
    - docs/17 vong 7: khong dat, thu hoi ket luan cu; CI phai xac nhan xanh
    - ghi blocker con lai: nguong pin LFP, SMS rate-limit/HMAC, IWDG STOP
    [pwr-rev-a.csv]
2026-11-09 Bo sung USB_SEL vao J_B2B (chan 20), ghi D-22; chay lai 35/35
    - spec/b2b.toml: chan 20 tu SPARE_SOC1 thanh USB_SEL do MCU dieu khien
    - sinh lai spec/generated; docs/03 cap nhat so chan du phong con 1
    - docs/11 them D-22
    - run_tests 35/35 tren Windows; CI run 7 (61ef85f) success
    [pinout_pwr_cmp.csv]
2026-11-09 Ghi chu ky thuat con lai: dong nap 470uF qua cong tac 2A, DC bias tu ra boost
    - BOM C3: dat sau cong tac, kiem CT
    - docs/18: them muc 8-9 ve bien du tai va derating tu
    [pwr-rev-a.csv]
2026-11-09 Giai quyet blocker: chon BQ25070, VSET buck, nguong pin LFP co loc, SMS HMAC
    - sac: chon BQ25070 (LFP 1S, float 3,5 V co dinh, power-path, NTC, standalone 1 A); BQ25798 bi loai
    - buck: thay 'thieu divider' bang dung mo hinh VSET 1 dien tro (R13), con cho gia tri datasheet
    - pin LFP: 3,05/2,90/3,20 V, dem 6/3/12 mau, EMA chi log; sua test battery/power/tickless/sim
    - SMS: HMAC-SHA256 + timestamp +-10 phut + chong replay + luu wake_last_ts; thieu secret thi tu choi
    - docs 02/04/17/18/19 cap nhat; con 5 blocker phan cung + gioi han tan suat MCU/whitelist
    - run_tests 35/35, 449 test + 5 kich ban
    [pwr-rev-a.csv]
2026-11-09 Sua loi BQ25070 (CTRL xung, NTC, power-path), nap pinout Core1106D, chan SMS rac
    - sac: CTRL la giao dien 11 xung = 935 mA, khong phai dien tro; them GPIO CHG_CTRL va firmware phat xung (2 test); R11 DNP
    - NTC BQ25070: R1=20k, R2=8.25k -> cat nong 44.9 C, lanh -0.6 C; tinh trong pwr-design + check
    - power-path: ghi ro BQ25070 chi 1.2 A, boost dau thang VBAT, pin cap dinh
    - B2B: PWR header duc TSM, CMP socket cai SSM, cat chan 26 lam khoa (D-24); R5 DNP
    - SMS: token counter + HMAC (khong phu thuoc RTC), gioi han 1 wake/10 phut o MCU, secret khong doi duoc tu xa
    - nap 112 chan Core1106D tu XLS Luckfox + 5 test
    - run_tests 36/36, 461 test; con 4 blocker ngoai (VSET, RI, camera, pack)
    [cmp-rev-b.csv, pins.csv, pwr-rev-a.csv]
2026-11-09 Cap nhat ket luan: 4 blocker ben ngoai (VSET, RI, camera, pack), CI xanh
    - liet ke dung 4 blocker con lai va viec do/kiem khong chan mua
    - ghi CI run 42619397175 cho 01931c3
2026-11-09 Them schematic khoi PWR/CMP sinh tu spec, kiem tra net va anh xem truoc
    - spec/schematic.toml: 20 block, 2 sheet, net giua PWR/CMP
    - renderer SVG + ERC net (moi net >=2 dau, TBD_VSET canh bao), 8 test
    - UART tach huong, USB tach host/modem/dich vu; B2B 26 chan tham chieu spec
    - run_tests 38/38, 469 test; pin-level van cho 4 blocker
2026-11-09 Dong 2 blocker: VSET=267k theo datasheet, pinout camera SC3336 20 chan
    - TPS62840 Table 1 trang 13: 3.3 V ung voi RSET 267k; BOM R13, parts verified
    - SC3336 3MP Camera (B): nap 20 chan tu PDF Luckfox, 6 test; schematic CAM dung MIPI/I2C that
    - schematic: them block R_VSET, het canh bao TBD; 21 block
    - con 2 blocker: RI modem, pack/BMS; run_tests 39/39, 475 test
    [pwr-rev-a.csv]
2026-11-09 Tu tim tai lieu: EC200U MAIN_RI chan 62, chon cell EVE 15Ah + BMS Daly
    - tai EC200U hardware design, xac nhan MAIN_RI pin 62 (1.8V, xung 120ms), USB 69/70, UART 67/68, SIM 14-17
    - EVB 40-pin khong dua RI ra, nen dung module/carrier thay breakout
    - chon cell EVE IFR33140-C33 15Ah + BMS Daly 1S 15A co NTC; con UN38.3/IEC va do tu tieu
    - spec/modem, spec/pack + 7 test; con 1 blocker PACK
    - run_tests 40/40, 481 test
2026-11-09 Sua port STM32L0 (RTC/WUCKSEL/IWDG), bao mat OTA/SMS, chat luong type, dong bo so lieu
    - port: chon LSI + PRER 127/255 + WUCKSEL /16 hoac ck_spre; IWDG mac dinh tat; them build.py port compile check
    - OTA/upload chi HTTPS, kiem redirect; test reject http
    - SMS: docstring counter, ghi watermark temp+fsync+replace, whitelist wake_numbers
    - mypy 0 loi (truoc 40), bandit 0 finding (truoc 8), ruff giam 118->22
    - cap nhat test 487, 41/41 buoc, sua so lieu README/docs17
    - con 1 blocker PACK (UN38.3/IEC + do tu tieu)
    [build.py, check.py, cli.py, clock.py, cloud.py, commands.py, config.py]
2026-11-09 Port STM32L0: cast mask 32-bit cho GCC -Werror
2026-11-09 Cho phep gia dinh PACK cho prototype, tach cong san xuat
    - pack status=assumed, prototype_allowed=true, gia dinh BMS 50 uA
    - parts check: PACK thanh warning cho prototype; --production fail neu thieu UN38.3/IEC
    - docs17/18/19/README: 0 blocker cung, 1 gia dinh; khong giao/van chuyen pack
    - 490 test, 41/41 buoc
    [check.py]
2026-11-09 Bat dau pin-level: thu vien ky hieu KiCad cho 4 IC nguon
    - BQ25070, TPS61088, TPS62840, TPS22918: day du chan + PAD theo datasheet
    - kicad-cli sym upgrade --force parse thanh cong
    - sinh pinout-power.md; 6 test; run_tests 43/43, 496 test
2026-11-09 Them netlist pin-level PWR va ERC
    - 34 linh kien, 4 IC nguon, day du net VBUS/VBAT/5V/3V3/tai
    - ERC: moi net >=2 dau, du rail, so chan khop symbol, FSW giua FSW-SW
    - xuat pwr-netlist.md/csv; 7 test; run_tests 45/45, 503 test
    [pwr-netlist.csv]
2026-11-09 Them netlist pin-level CMP: SoC, camera, modem carrier, USB mux, SD, B2B
    - 12 linh kien; MIPI 2 lane, USB qua TS3USB221A, UART tach huong
    - camera SC3336 khong co PWDN: da bo khoi netlist
    - ERC: moi net >=2 dau, chan SoC/camera khop tai lieu
    - xuat cmp-netlist.md/csv; 7 test; run_tests 47/47, 510 test
    [cmp-netlist.csv]
2026-11-09 Dong bo ref netlist CMP voi BOM: TP1, R1, C1, C2
    [cmp-netlist.csv]
2026-11-09 Dong bo ref PWR voi BOM, them R17/R18/L2/J6/C13-C17
    - netlist PWR: U1 boost, U2 buck, U3 charger; J2 B2B, J3 pack, J6 interface
    - BOM: them IMON, CHG pull-up, buck inductor, bulk/decouple, header 1x9
    - test rang buoc moi ref netlist phai co trong BOM
    - 512 test, 47/47 buoc
    [cmp-rev-b.csv, pwr-netlist.csv, pwr-rev-a.csv]
2026-11-09 Ghi nhan 3 vong kiem tra 8-10 va ket luan du dieu kien dung prototype
    - 3 vong: 47/47 buoc, 512 test, 26/26 readiness
    - CI 8a23349 success; datasheet/gcc da doi chieu
    - con 1 gia dinh PACK; chua co schematic/PCB va do G0
2026-11-09 Ve schematic KiCad PWR pin-level: 5 IC, global label, ERC 0 loi
    - flytex-pwr.kicad_sch + PDF; kicad-cli export netlist thanh cong
    - ERC 0 error sau khi them PWR_FLAG va sua kieu chan trung
    - 4 test; run_tests 49/49, 516 test
    [flytex-pwr.kicad_sch]
2026-11-09 Ve schematic day du PWR va CMP: IC, R/C/L, connector, label
    - flytex-pwr-full: 40 linh kien, ERC 0
    - flytex-cmp-full: SoC, camera, modem, SD, mux, connector, ERC 0
    - PDF/PNG A0; 4 test; run_tests 51/51, 520 test
    [flytex-cmp-full.kicad_sch, flytex-pwr-full.kicad_sch]
2026-11-09 Them fab readiness gate va bao cao goi san xuat
    - fab_check: PCB/Gerber/drill/CPL/DRC/stackup/footprint
    - hien tai 7 hang muc thieu; khong the gui xuong
    - gan footprint header chuan cho J6/J3/J5; con 5 footprint co khi
    [cmp-netlist.csv, flytex-cmp-full.kicad_sch, flytex-pwr-full.kicad_sch, pwr-netlist.csv]
2026-11-09 Ghi ro footprint con thieu truoc khi layout
2026-11-09 Cap nhat footprint co san va huong dan tao footprint chinh xac
    - TPS61088 RHL, TPS62840 VSON, XT30, FPC, B2B socket
    - con 4 footprint co khi: B2B PWR, Core1106D, service pad, TP1
    - them hardware/fab/footprint-guide.md
    [cmp-netlist.csv, flytex-cmp-full.kicad_sch, flytex-pwr-full.kicad_sch, pwr-netlist.csv]
2026-11-09 Regenerate schematic PWR sau khi doi footprint
    [flytex-pwr.kicad_sch]
2026-11-09 Them lo trinh khoang cach toi PCBA va devkit
2026-11-09 Them goi devkit san sang truoc khi mua: BOM, wiring, flash, config, scripts, test
    - docs/21: ke hoach 2 muc tieu (devkit 2-4 tuan, PCBA 3-6 thang)
    - devkit/: BOM, wiring, flash, provisioning, systemd, dry-run check, feature test
    - 5 test devkit; run_tests 53/53, 525 test
    [bom.csv]
2026-11-09 Chi tiet dau day devkit: UART, camera, modem, nguon, thu tu cap nguon
    - canh bao USB-C va USB-A dung chung, khong the vua cap nguon vua modem
    - bang dau day, kiem tra AT, loi thuong gap, an toan
    [bom.csv]
